MrChros/MIDI_Lighter/Doc/Calculations/Random_MIDI_Data_XR18_01.png

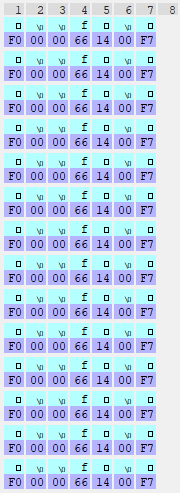
Doc/Calculations/Random_MIDI_Data_XR18_01.png
