MrChros/MIDI_Lighter/Doc/Calculations/Random_MIDI_Data_XR18_02.png

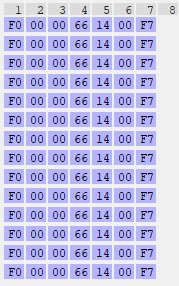
Doc/Calculations/Random_MIDI_Data_XR18_02.png
