MrChros/MIDI_Lighter/Doc/Calculations/Random_MIDI_Data_XR18_03.png

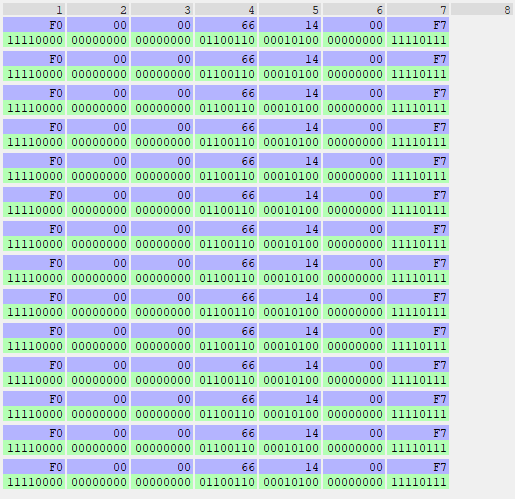
Doc/Calculations/Random_MIDI_Data_XR18_03.png
