MrChros/MIDI_Lighter/Doc/Circuit_Ideas/AD8217_Protection_Circuit.png

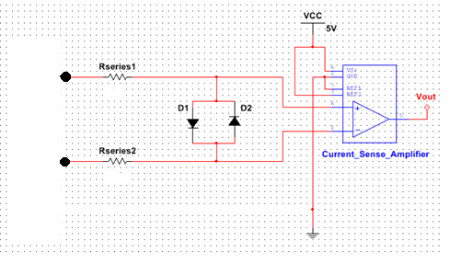
Doc/Circuit_Ideas/AD8217_Protection_Circuit.png
