MrChros/MIDI_Lighter/Doc/Circuit_Ideas/Ersatz74LS07.PNG

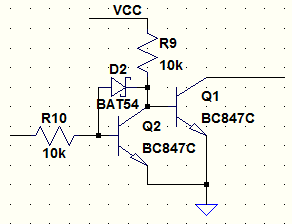
Doc/Circuit_Ideas/Ersatz74LS07.PNG
