MrChros/MIDI_Lighter/Doc/BOM_LCSC_MV.xlsx

Note: precise search for LCSC part number.
Quantity | Manufacture Part Number | Manufacturer(optional) | Description(optional) | LCSC Part Number(optional) | Package(optional)
100 | 0805W8F1000T5E | Uniroyal Elec | Chip Resistor - Surface Mount 0805 | C17408 | 0805
100 | 0805W8F1001T5E | Uniroyal Elec | Chip Resistor - Surface Mount 0805 | C17513 | 0805
100 | 0805W8F1002T5E | Uniroyal Elec | Chip Resistor - Surface Mount 0805 | C17414 | 0805
30 | - | Hubei KENTO Elec | Light Emitting Diodes (LED) 0805 | C2297 | 0805
20 | 17-21SUYC/TR8 | Hubei KENTO Elec | Light Emitting Diodes (LED) 0805 | C2296 | 0805
20 | 17-21/BHC-AP1Q2/3T | Everlight Elec | Light Emitting Diodes (LED) 0805 | C99870 | 0805
20 | - | Hubei KENTO Elec | Light Emitting Diodes (LED) 0805 | C34499 | 0805
15 | IRLML2246TRPBF | Infineon Technologies | MOSFET SOT-23(SOT-23-3) | C127272 | SOT-23(SOT-23-3)
7 | LM1117MPX-5.0/NOPB | Texas Instruments | Low Dropout Regulators(LDO) SOT-223 RoHS | C9663 | SOT-223
7 | MCP1703AT-5002E/CB | Microchip Tech | Low Dropout Regulators(LDO) SOT-23(SOT-23-3) | C144342 | SOT-23(SOT-23-3)
10 | HC-49SM16MHz20pF30ppm | Zhejiang Abel Elec | 49SMD 16MHz ±30ppm 49SMD | C111377 | 49SMD
10 | - | Shenzhen Cankemeng | Male Header Plugin | C124373 | Plugin
7 | 10118193-0001LF | Amphenol ICC | USB Connectors Female Horizontal USB 2.0 1 SMD RoHS | C132562 | SMD
7 | CR2512F0R05E042W | Ever Ohms Tech | Ultra Low Resistors (SMD) 2512 | C176035 | 2512
7 | AD8217BRMZ-R7 | Analog Devices | Operational Amplifiers MSOP-8 | C141937 | MSOP-8
