MrChros/MIDI_Lighter/Doc/Costs.xls

Sheet: Import
Spalte1 | Spalte2 | Spalte3

Sheet: Multi-Voltage (MV)
 |  |  |  |  |  |  |  |  |  |  |  |  |  |  |  |  |  |  | Yes
Components available at both stores: |  |  |  |  |  |  |  |  |  |  |  |  |  |  |  |  |  |  | No
# | Component | Amount | Reichelt Code | Reichelt per Piece | Min. Reichelt | Final Reichelt | Reichelt Total | LCSC Code | LCSC per Piece | Min. LCSC | Final LCSC | LCSC Avail. | LCSC Total | Avail. | Have to Reichelt | Have to LCSC | Have to Min. | Store
1 | Resistor 22 | 2 | RND 0805 1 22 | 0.02 € | 1 | 14 | 0.28 € | C65068 | 0.01 € | 100 | 100 | Yes | 0.69 € | Yes | 0.00 € | 0.00 € | 0.00 € | -
2 | Resistor 100 | 6 | RND 0805 1 100 | 0.02 € | 1 | 40 | 0.80 € | C17408 | 0.0033 € | 100 | 100 | Yes | 0.33 € | No | 0.80 € | 0.33 € | 0.33 € | LCSC
3 | Resistor 220 | 3 | RND 0805 1 220 | 0.02 € | 1 | 20 | 0.40 € | C17557 | 0.0045 € | 100 | 100 | Yes | 0.45 € | Yes | 0.00 € | 0.00 € | 0.00 € | -
4 | Resistor 500 | 4 | RND 0805 1 510 | 0.02 € | 1 | 25 | 0.50 € | C17734 | 0.0039 € | 100 | 100 | Yes | 0.39 € | Yes | 0.00 € | 0.00 € | 0.00 € | -
5 | Resistor 1k | 4 | SMD-0805 1,00K | 0.03 € | 1 | 25 | 0.75 € | C17513 | 0.01 € | 100 | 100 | Yes | 0.51 € | No | 0.75 € | 0.51 € | 0.51 € | LCSC
6 | Resistor 2k | 3 | SPR-0805 2,00K | 0.25 € | 1 | 20 | 5.00 € | C17604 | 0.0045 € | 100 | 100 | Yes | 0.45 € | Yes | 0.00 € | 0.00 € | 0.00 € | -
7 | Resistor 10k | 10 | SMD-0805 10,0K | 0.03 € | 1 | 50 | 1.50 € | C17414 | 0.01 € | 100 | 100 | Yes | 0.51 € | No | 1.50 € | 0.51 € | 0.51 € | LCSC
8 | Resistor 33k | 1 | SMD-0805 33,0K | 0.03 € | 1 | 7 | 0.21 € | C17633 | 0.0041 € | 100 | 100 | Yes | 0.41 € | Yes | 0.00 € | 0.00 € | 0.00 € | -
9 | Resistor 120k | 1 | SMD-0805 120K | 0.03 € | 1 | 7 | 0.21 € | C17436 | 0.0033 € | 100 | 100 | Yes | 0.33 € | Yes | 0.00 € | 0.00 € | 0.00 € | -
10 | Capacitor 22p | 2 | KEM C0G0805 22P | 0.01 € | 1 | 14 | 0.14 € | C38143 | 0.02 € | 50 | 50 | Yes | 0.84 € | Yes | 0.00 € | 0.00 € | 0.00 € | -
11 | Capacitor 100n | 3 | KEM Z5U0805 100N | 0.03 € | 1 | 20 | 0.60 € | C85866 | 0.06 € | 10 | 20 | Yes | 1.17 € | Yes | 0.00 € | 0.00 € | 0.00 € | -
12 | Capacitor 1u | 4 | KEM Y5V0805 1,0U | 0.01 € | 1 | 25 | 0.25 € | C28323 | 0.04 € | 10 | 30 | Yes | 1.25 € | Yes | 0.00 € | 0.00 € | 0.00 € | -
13 | Capacitor 10u Tantal | 2 | TPS 3225 10/20 | 0.32 € | 1 | 14 | 4.48 € | C189401 | 0.80 € | 1 | 14 | Yes | 11.24 € | No | 4.48 € | 11.24 € | 4.48 € | Reichelt
14 | LED Green | 4 | LG R971 | 0.05 € | 1 | 25 | 1.25 € | C2297 | 0.02 € | 10 | 30 | Yes | 0.46 € | No | 1.25 € | 0.46 € | 0.46 € | LCSC
15 | LED Orange/Gelb | 1 | LY R976 | 0.06 € | 1 | 7 | 0.42 € | C2296 | 0.01 € | 20 | 20 | Yes | 0.20 € | No | 0.42 € | 0.20 € | 0.20 € | LCSC
16 | LED Blue | 1 | RND 135-00047 | 0.07 € | 1 | 7 | 0.49 € | C99870 | 0.03 € | 10 | 10 | Yes | 0.34 € | No | 0.49 € | 0.34 € | 0.34 € | LCSC
17 | LED White | 1 | LED LL 0805 WS | 0.16 € | 1 | 7 | 1.12 € | C34499 | 0.01 € | 20 | 20 | Yes | 0.27 € | No | 1.12 € | 0.27 € | 0.27 € | LCSC
18 | n-MOSFET IRLML6346 | 6 | IRLML 6346 | 0.18 € | 1 | 37 | 6.66 € | C67276 | 0.10 € | 5 | 40 | No | 3.88 € | No | 6.66 € | 3.88 € | 3.88 € | Reichelt
19 | p-MOSFET IRLML2246 | 2 | IRLML 2246 | 0.14 € | 1 | 13 | 1.82 € | C127272 | 0.11 € | 5 | 15 | Yes | 1.61 € | No | 1.82 € | 1.61 € | 1.61 € | LCSC
20 | p-MOSFET IRF7416 | 1 | IRF 7416 | 0.47 € | 1 | 7 | 3.29 € | C3000 | 0.37 € | 1 | 7 | Yes | 2.58 € | Yes | 0.00 € | 0.00 € | 0.00 € | -
21 | LM 1117 MPX-5.0 | 1 | LM 1117 MPX-5.0 | 0.86 € | 1 | 7 | 6.02 € | C9663 | 0.74 € | 1 | 7 | Yes | 5.15 € | No | 6.02 € | 5.15 € | 5.15 € | LCSC
22 | MCP1703CB | 1 | MCP 1703T-3302E | 0.76 € | 1 | 7 | 5.32 € | C144342 | 0.44 € | 1 | 7 | Yes | 3.09 € | No | 5.32 € | 3.09 € | 3.09 € | LCSC
23 | ATmega32u4 | 1 | ATXMEGA 32A4U-AU | 2.80 € | 1 | 7 | 19.60 € | C44854 | 3.34 € | 1 | 7 | Yes | 23.35 € | No | 19.60 € | 23.35 € | 19.60 € | Reichelt
24 | ATtiny13 | 1 | ATTINY 13A-SSU | 0.88 € | 1 | 7 | 6.16 € | C9805 | 0.64 € | 1 | 7 | No | 4.49 € | No | 6.16 € | 4.49 € | 4.49 € | Reichelt
25 | 74LS14D | 1 | SMD LS 14 | 0.27 € | 1 | 7 | 1.89 € | C7653 | 0.96 € | 1 | 7 | Yes | 6.73 € | No | 1.89 € | 6.73 € | 1.89 € | Reichelt
26 | Optokoppler H11L1M | 1 | H11L1M | 0.48 € | 1 | 7 | 3.36 € | C16587 | 0.39 € | 1 | 7 | No | 2.75 € | No | 3.36 € | 2.75 € | 2.75 € | Reichelt
27 | Quarz CSM-7X-DU | 1 | 16,0000-HC49-SMD | 0.29 € | 1 | 7 | 2.03 € | C111377 | 0.07 € | 5 | 10 | Yes | 0.70 € | No | 2.03 € | 0.70 € | 0.70 € | LCSC
28 | Pin Header 1x11 | 1 | MPE 087-1-012 | 0.28 € | 1 | 7 | 1.96 € | C124373 | 0.07 € | 5 | 10 | Yes | 0.65 € | No | 1.96 € | 0.65 € | 0.65 € | LCSC
29 | npn-Transistor BC847C | 2 | BC 847C NXP | 0.02 € | 1 | 13 | 0.26 € | C150094 | 0.02 € | 20 | 20 | Yes | 0.33 € | No | 0.26 € | 0.33 € | 0.26 € | Reichelt
30 | Schottky-Diode BAT54 | 1 | BAT 54 SMD | 0.03 € | 1 | 7 | 0.21 € | C188282 | 0.04 € | 10 | 10 | Yes | 0.36 € | No | 0.21 € | 0.36 € | 0.21 € | Reichelt
 |  |  |  |  |  |  |  |  |  |  |  |  |  |  | Reichelt | LCSC | Minimum
 |  |  |  |  |  | Total: | 76.98 € |  |  |  | Total: |  | 75.50 € |  | 66.10 € | 66.94 € | 51.38 €
 |  |  |  |  |  |  |  |  |  |  |  |  |  |  |  | Reichelt: | 37.56 €
Left over components: |  |  |  |  |  |  |  |  |  |  |  |  |  |  |  | LCSC: | 13.82 €
# | Component | Amout | Reichelt | LCSC
1 | 2.5MM_SMD_PUSHBUTTON | 2 |  |  |  |  |  |  |  |  |  |  |  |  |  | Summe: | 51.38 €
2 | DIN-Buchse, 5-polig | 2 | MABPM 5S
3 | H11L1M Socket | 1 | GS 6P
4 | Micro USB Plug | 1 |  | C132562
5 | Diode 1N4001 | 1 | 1N 4001 SMD
6 | Diode 1N914 | 1 | 1N 914
7 | n-MOSFET AO3400A | 0 |  | C20917
8 | Shunt Resistor 0,05/1W | 0 |  | C176035
9 | Stromshunt Monitor AD8217 | 0 |  | C141937
10 | Connector RGB-Strip | 1
11 | Adapter Power Supply | 1 | DC BU21 90
12 | Distanzhülsen, M3, 5mm |  | DA 5MM
13 | Distanzhülsen, M3, 5mm |  | DI 5MM
14 | Distanzhülsen, M3, 10mm |  | DA 10MM
15 | Distanzhülsen, M3, 10mm |  | DI 10MM
16 | Sechskantmuttern, M3 |  | SK M3
17 | Schrauben, M3, 6 mm |  | SZK M3X6-200
18 | Schrauben, M3, 10 mm |  | SZK M3X10-200
19 | Schrauben, M3, 25 mm |  | SZK M3X25-200
 | Components per board: | 82

Sheet: +12V Only
 |  |  |  |  |  |  |  |  |  |  |  |  |  |  |  |  |  |  | Yes
Components available at both stores: |  |  |  |  |  |  |  |  |  |  |  |  |  |  |  |  |  |  | No
# | Component | Amount | Reichelt Code | Reichelt per Piece | Min. Reichelt | Final Reichelt | Reichelt Total | LCSC Code | LCSC per Piece | Min. LCSC | Final LCSC | LCSC Avail. | LCSC Total | Avail. | Have to Reichelt | Have to LCSC | Have to Min. | Store
1 | Resistor 22 | 2 | RND 0805 1 22 | 0.02 € | 1 | 14 | 0.28 € | C65068 | 0.01 € | 100 | 100 | Yes | 0.69 € | Yes | 0.00 € | 0.00 € | 0.00 € | -
2 | Resistor 100 | 4 | RND 0805 1 100 | 0.02 € | 1 | 25 | 0.50 € | C17408 | 0.0033 € | 100 | 100 | Yes | 0.33 € | No | 0.50 € | 0.33 € | 0.33 € | LCSC
3 | Resistor 220 | 3 | RND 0805 1 220 | 0.02 € | 1 | 20 | 0.40 € | C17557 | 0.0045 € | 100 | 100 | Yes | 0.45 € | Yes | 0.00 € | 0.00 € | 0.00 € | -
4 | Resistor 500 | 4 | RND 0805 1 510 | 0.02 € | 1 | 25 | 0.50 € | C17734 | 0.0039 € | 100 | 100 | Yes | 0.39 € | Yes | 0.00 € | 0.00 € | 0.00 € | -
5 | Resistor 1k | 2 | SMD-0805 1,00K | 0.03 € | 1 | 15 | 0.45 € | C17513 | 0.01 € | 100 | 100 | Yes | 0.51 € | Yes | 0.00 € | 0.00 € | 0.00 € | -
6 | Resistor 2k | 1 | SPR-0805 2,00K | 0.25 € | 1 | 7 | 1.75 € | C17604 | 0.0045 € | 100 | 100 | Yes | 0.45 € | Yes | 0.00 € | 0.00 € | 0.00 € | -
7 | Resistor 10k | 8 | SMD-0805 10,0K | 0.03 € | 1 | 50 | 1.50 € | C17414 | 0.01 € | 100 | 100 | Yes | 0.51 € | No | 1.50 € | 0.51 € | 0.51 € | LCSC
8 | Capacitor 22p | 2 | KEM C0G0805 22P | 0.01 € | 1 | 15 | 0.15 € | C38143 | 0.02 € | 50 | 50 | Yes | 0.84 € | Yes | 0.00 € | 0.00 € | 0.00 € | -
9 | Capacitor 100n | 3 | KEM Z5U0805 100N | 0.03 € | 1 | 20 | 0.60 € | C85866 | 0.06 € | 10 | 20 | Yes | 1.17 € | Yes | 0.00 € | 0.00 € | 0.00 € | -
10 | Capacitor 1u | 2 | KEM Y5V0805 1,0U | 0.01 € | 1 | 15 | 0.15 € | C28323 | 0.04 € | 10 | 10 | Yes | 0.42 € | Yes | 0.00 € | 0.00 € | 0.00 € | -
11 | Capacitor 10u Tantal | 2 | TPS 3225 10/20 | 0.32 € | 1 | 14 | 4.48 € | C189401 | 0.80 € | 1 | 14 | Yes | 11.24 € | No | 4.48 € | 11.24 € | 4.48 € | Reichelt
12 | LED Green | 4 | LG R971 | 0.05 € | 1 | 25 | 1.25 € | C2297 | 0.02 € | 10 | 30 | Yes | 0.46 € | No | 1.25 € | 0.46 € | 0.46 € | LCSC
13 | LED Orange/Gelb | 1 | LY R976 | 0.06 € | 1 | 7 | 0.42 € | C2296 | 0.01 € | 20 | 20 | Yes | 0.20 € | No | 0.42 € | 0.20 € | 0.20 € | LCSC
14 | n-MOSFET IRLML6346 | 4 | IRLML 6346 | 0.18 € | 1 | 25 | 4.50 € | C67276 | 0.10 € | 5 | 25 | No | 2.43 € | No | 4.50 € | 2.43 € | 2.43 € | Reichelt
15 | p-MOSFET IRF7416 | 1 | IRF 7416 | 0.47 € | 1 | 7 | 3.29 € | C3000 | 0.37 € | 1 | 7 | Yes | 2.58 € | Yes | 0.00 € | 0.00 € | 0.00 € | -
16 | LM 1117 MPX-5.0 | 1 | LM 1117 MPX-5.0 | 0.86 € | 1 | 7 | 6.02 € | C9663 | 0.74 € | 1 | 7 | Yes | 5.15 € | No | 6.02 € | 5.15 € | 5.15 € | LCSC
17 | ATmega32u4 | 1 | ATXMEGA 32A4U-AU | 2.80 € | 1 | 7 | 19.60 € | C44854 | 3.34 € | 1 | 7 | Yes | 23.35 € | No | 19.60 € | 23.35 € | 19.60 € | Reichelt
18 | 74LS14D | 1 | SMD LS 14 | 0.27 € | 1 | 7 | 1.89 € | C7653 | 0.96 € | 1 | 7 | Yes | 6.73 € | No | 1.89 € | 6.73 € | 1.89 € | Reichelt
19 | Optokoppler H11L1M | 1 | H11L1M | 0.48 € | 1 | 7 | 3.36 € | C16587 | 0.39 € | 1 | 7 | No | 2.75 € | No | 3.36 € | 2.75 € | 2.75 € | Reichelt
20 | Quarz CSM-7X-DU | 1 | 16,0000-HC49-SMD | 0.29 € | 1 | 7 | 2.03 € | C111377 | 0.07 € | 5 | 10 | Yes | 0.70 € | No | 2.03 € | 0.70 € | 0.70 € | LCSC
21 | Pin Header 1x11 | 1 | MPE 087-1-012 | 0.28 € | 1 | 7 | 1.96 € | C124373 | 0.07 € | 5 | 10 | Yes | 0.65 € | No | 1.96 € | 0.65 € | 0.65 € | LCSC
22 | npn-Transistor BC847C | 2 | BC 847C NXP | 0.02 € | 1 | 13 | 0.26 € | C150094 | 0.02 € | 20 | 20 | Yes | 0.33 € | No | 0.26 € | 0.33 € | 0.26 € | Reichelt
23 | Schottky-Diode BAT54 | 1 | BAT 54 SMD | 0.03 € | 1 | 7 | 0.21 € | C188282 | 0.04 € | 10 | 10 | Yes | 0.36 € | No | 0.21 € | 0.36 € | 0.21 € | Reichelt
 |  |  |  |  |  |  |  |  |  |  |  |  |  |  | Reichelt | LCSC | Minimum
 |  |  |  |  |  | Total: | 55.55 € |  |  |  | Total: |  | 62.68 € |  | 47.98 € | 55.19 € | 39.62 €
 |  |  |  |  |  |  |  |  |  |  |  |  |  |  |  | Reichelt: | 31.62 €
Left over components: |  |  |  |  |  |  |  |  |  |  |  |  |  |  |  | LCSC: | 8.00 €
# | Component | Amout | Reichelt | LCSC
1 | 2.5MM_SMD_PUSHBUTTON | 2 |  |  |  |  |  |  |  |  |  |  |  |  |  | Summe: | 39.62 €
2 | DIN-Buchse, 5-polig | 2 | MABPM 5S
3 | H11L1M Socket | 1 | GS 6P
4 | Micro USB Plug | 1 |  | C132562
5 | Diode 1N4001 | 1 | 1N 4001 SMD
6 | Diode 1N914 | 1 | 1N 914
7 | n-MOSFET AO3400A | 0 |  | C20917
8 | Shunt Resistor 0,05/1W | 0 |  | C176035
9 | Stromshunt Monitor AD8217 | 0 |  | C141937
10 | Connector RGB-Strip | 1
11 | Adapter Power Supply | 1 | DC BU21 90
12 | Distanzhülsen, M3, 5mm |  | DA 5MM
13 | Distanzhülsen, M3, 5mm |  | DI 5MM
14 | Distanzhülsen, M3, 10mm |  | DA 10MM
15 | Distanzhülsen, M3, 10mm |  | DI 10MM
16 | Sechskantmuttern, M3 |  | SK M3
17 | Schrauben, M3, 6 mm |  | SZK M3X6-200
18 | Schrauben, M3, 10 mm |  | SZK M3X10-200
19 | Schrauben, M3, 25 mm |  | SZK M3X25-200
 | Components per board: | 62
