MrChros/MIDI_Lighter/Housing/MIDI_Lighter_12V_Only_Top_Debug.stl

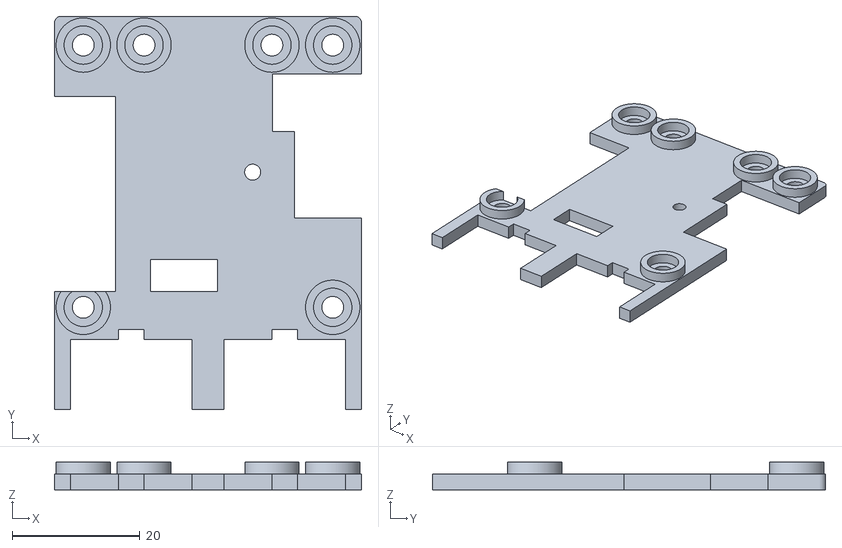
[picture p7: CAD file, 2022-03-05]
Housing/MIDI_Lighter_12V_Only_Top_Debug.stl
48.0 x 61.5 x 4.38
