MrChros/MIDI_Lighter/Housing/MIDI_Lighter_12V_Only_Top_Cable_Relief.stl

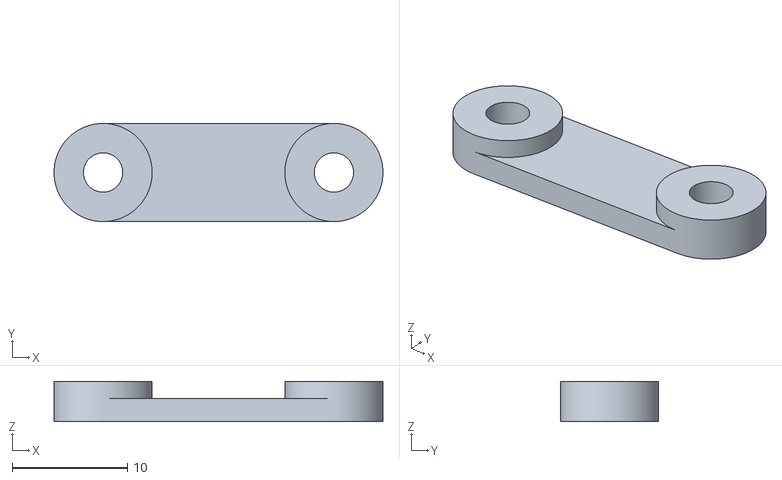
[picture p8: CAD file, 2022-03-05]
Housing/MIDI_Lighter_12V_Only_Top_Cable_Relief.stl
28.5 x 8.50 x 3.50
