MrChros/MIDI_Lighter/Housing/MIDI_Lighter_12V_Only_Bottom.stl

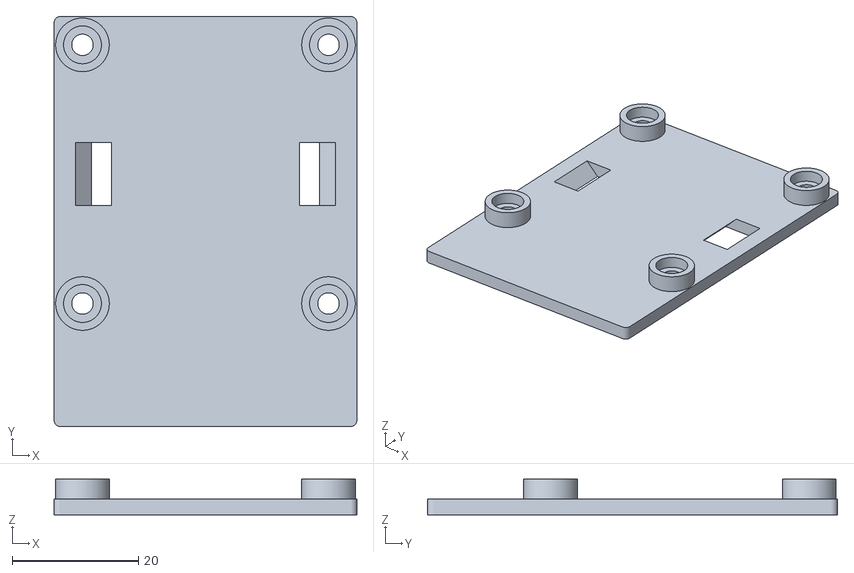
[picture p9: CAD file, 2022-03-05]
Housing/MIDI_Lighter_12V_Only_Bottom.stl
48.0 x 65.0 x 5.70
