MrChros/MIDI_Lighter/(list of files, cad)

Other CAD files:
Housing/MIDI_Lighter_12V_Only_Top_Debug.scad
