MrChros/MIDI_Lighter/Doc/Calculations/Current_Measurement.xlsx

 |  |  | Prescaler 4 |  | Prescaler 8 |  | Prescaler 16 |  | Prescaler 32 |  | Prescaler 64 |  | Reference Voltage: | 5000 | mV | 401
Timer4 Prescaler | Timer1 Top | #Measurement | ADC_Value | Current [mA] | ADC_Value | Current [mA] | ADC_Value | Current [mA] | ADC_Value | Current [mA] | ADC_Value | Current [mA] | ADC Resolution: | 1024
PRESCALER_4 | 4000 | 0 | 0.922 | 4.502 | 13.000 | 63.477 | 13.262 | 64.756 | 13.333 | 65.100 | 13.424 | 65.545
PRESCALER_4 | 4000 | 1 | 12.671 | 61.872 | 13.055 | 63.745 | 13.251 | 64.703 | 13.592 | 66.368 | 13.738 | 67.080
PRESCALER_4 | 4000 | 2 | 12.654 | 61.785 | 13.073 | 63.833 | 13.124 | 64.082 | 13.324 | 65.060 | 13.614 | 66.476
PRESCALER_4 | 4000 | 3 | 12.746 | 62.238 | 12.996 | 63.455 | 13.483 | 65.837 | 13.498 | 65.906 | 13.590 | 66.357
PRESCALER_4 | 4000 | 4 | 12.785 | 62.426 | 13.059 | 63.766 | 13.226 | 64.581 | 13.389 | 65.377 | 13.443 | 65.642
PRESCALER_4 | 4000 | 5 | 12.751 | 62.261 | 12.908 | 63.027 | 13.332 | 65.097 | 13.671 | 66.754 | 13.421 | 65.534
PRESCALER_4 | 4000 | 6 | 12.753 | 62.273 | 13.114 | 64.033 | 13.212 | 64.512 | 13.507 | 65.952 | 13.829 | 67.527
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
