MrChros/MIDI_Lighter/Doc/Export/MIDI_Lighter_PCB_Concept_12V.pdf

H

G

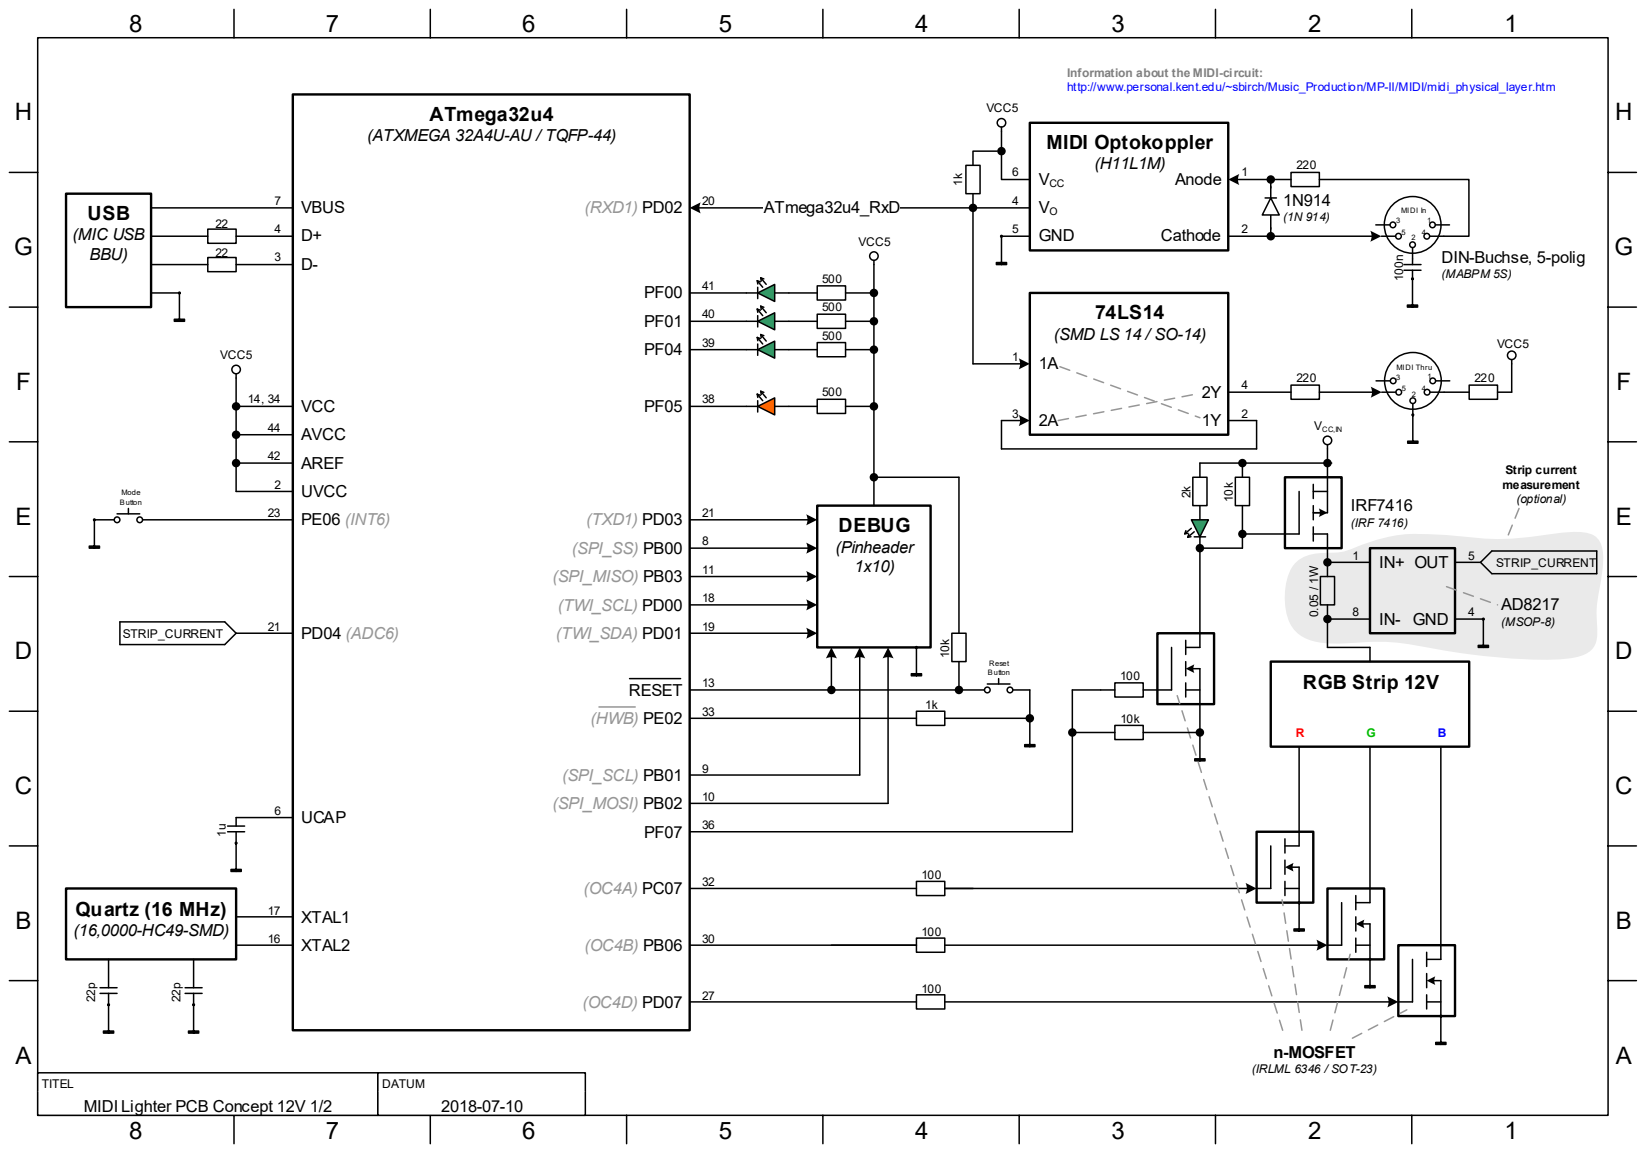
[picture p13: page 1]
DATUM; ATmega32u4; (ATXMEGA 32A4U-AU / TQFP-44); MIDI Optokoppler; ATmega32u4_RxD; DIN-Buchse, 5-polig; (MABPM 5S); Anode; GND; Cathode; VCC; VCC5; VBUS; (RXD1) PD02 ⁷; 22 USB; (MIC USB BBU); XTAL1; XTAL2; Quartz (16 MHz); (16,0000-HC49-SMD) 22p; PE06 (INT6); n-MOSFET; (IRLML 6346 / SOT-23); VCC,IN; RGB Strip 12V; 21 (TXD1) PD03; (SPI_SS) PB00; (SPI_SCL) PB01; 10 (SPI_MOSI) PB02; 11 (SPI_MISO) PB03; DEBUG; (Pinheader 1x10); 13 RESET; UCAP; AVCC; AREF; UVCC; (TWI_SCL) PD00; (TWI_SDA) PD01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

Information about the MIDI-circuit:
http://www.personal.kent.edu/~sbirch/Music_Production/MP-II/MIDI/midi_physical_layer.htm

(SMD LS 14 / SO-14)

TITEL
MIDI Lighter PCB Concept 12V 1/2

H

G

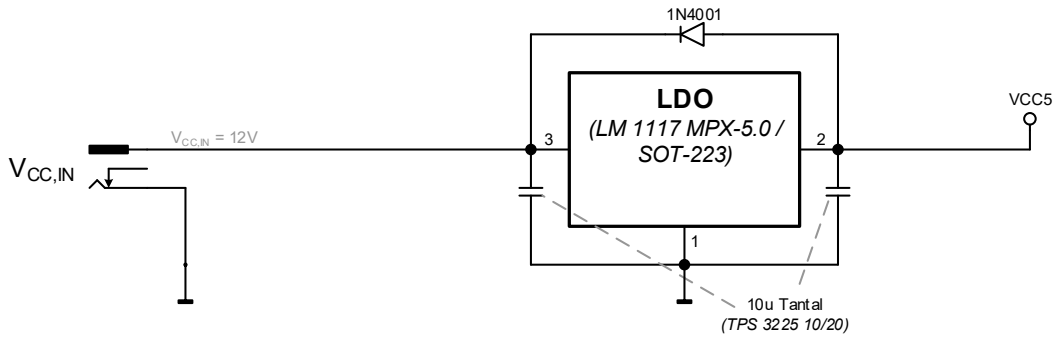
[picture p14: page 2]
DATUM; LDO; (LM 1117 MPX-5.0 / SOT-223); 10u Tantal (TPS 3225 10/20); VCC5; VCC,IN = 12V; VCC,IN

TITEL
MIDI Lighter PCB Concept 12V 2/2
