MrChros/MIDI_Lighter/Doc/Export/MIDI_Lighter_PCB_Concept_MV.pdf

H

G

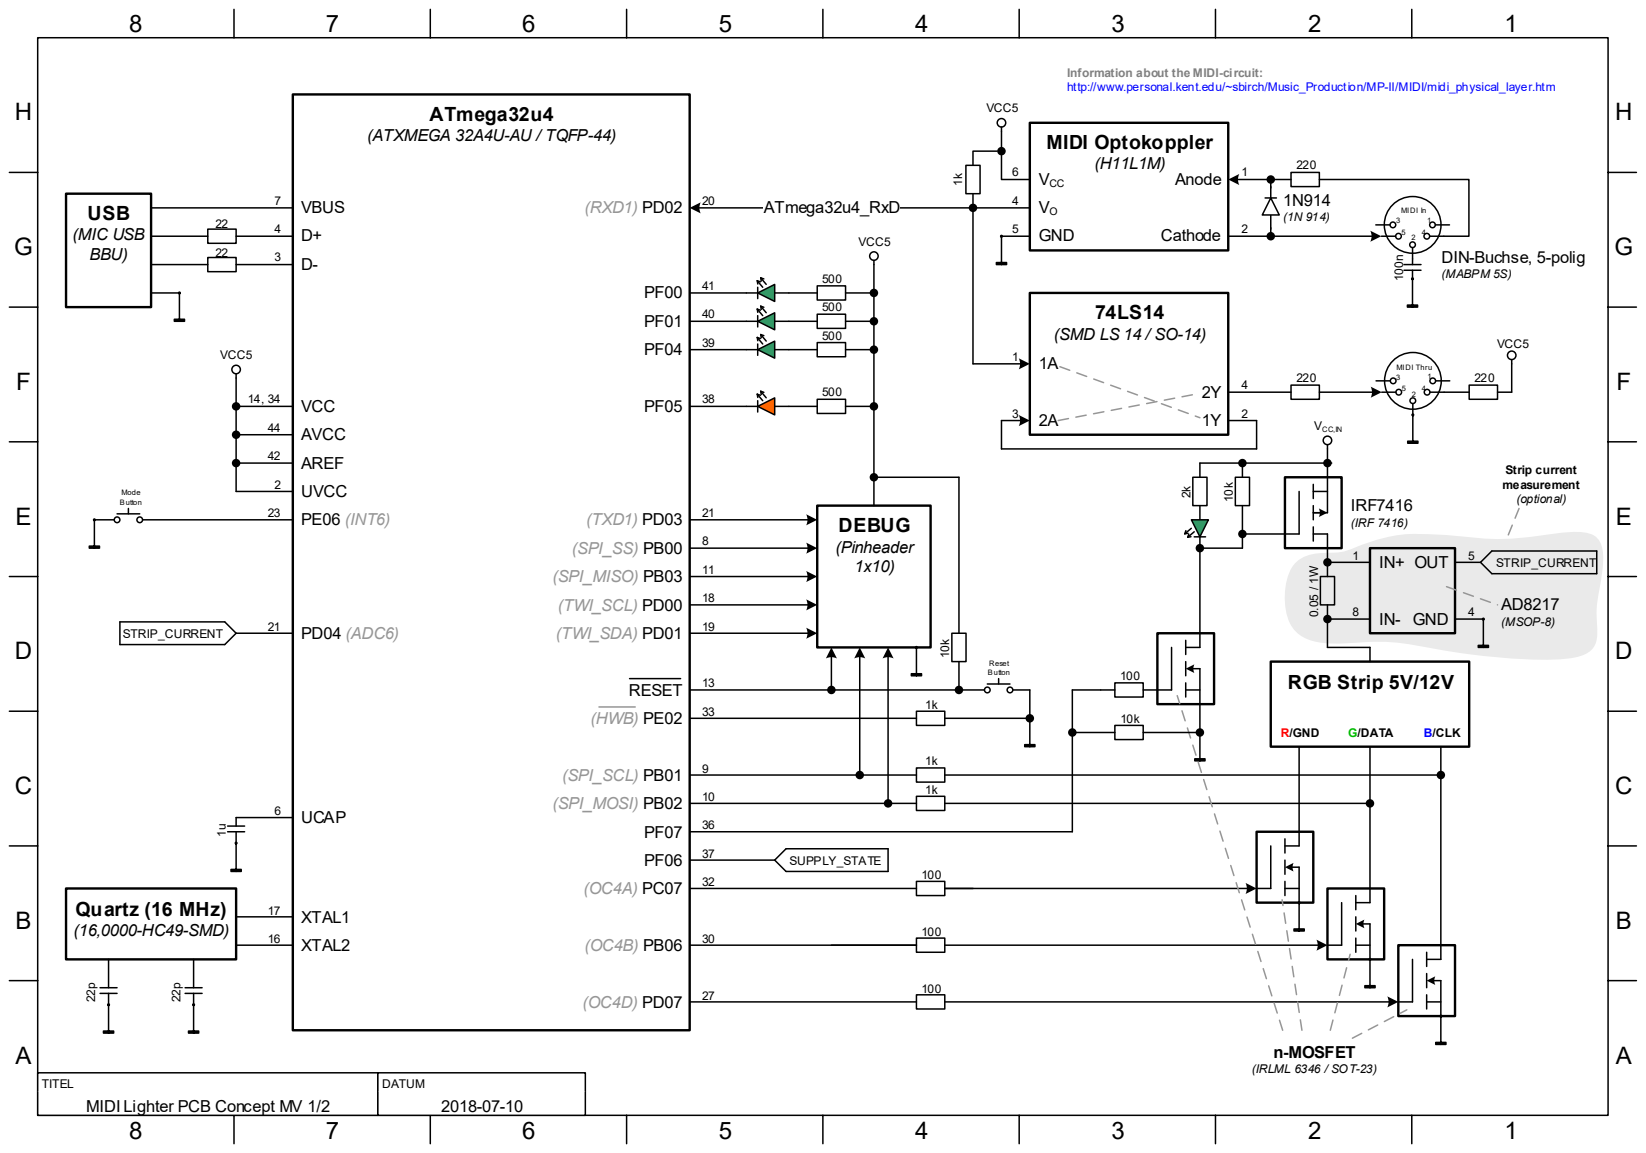
[picture p15: page 1]
ATmega32u4; (ATXMEGA 32A4U-AU / TQFP-44); MIDI Optokoppler; ATmega32u4_RxD; DIN-Buchse, 5-polig; (MABPM 5S); Anode; GND; Cathode; VCC; VCC5; VBUS; (RXD1) PD02 ⁷; 22 USB; (MIC USB BBU); XTAL1; XTAL2; Quartz (16 MHz); (16,0000-HC49-SMD) 22p; PE06 (INT6); n-MOSFET; (IRLML 6346 / SOT-23); VCC,IN; RGB Strip 5V/12V; R/GND; G/DATA; B/CLK; 21 (TXD1) PD03; (SPI_SS) PB00; (SPI_SCL) PB01; 10 (SPI_MOSI) PB02; 11 (SPI_MISO) PB03; DEBUG; (Pinheader 1x10); 13 RESET; UCAP; AVCC; AREF; UVCC; (TWI_SCL) PD00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

Information about the MIDI-circuit:
http://www.personal.kent.edu/~sbirch/Music_Production/MP-II/MIDI/midi_physical_layer.htm

(SMD LS 14 / SO-14)

TITEL
MIDI Lighter PCB Concept MV 1/2

H

G

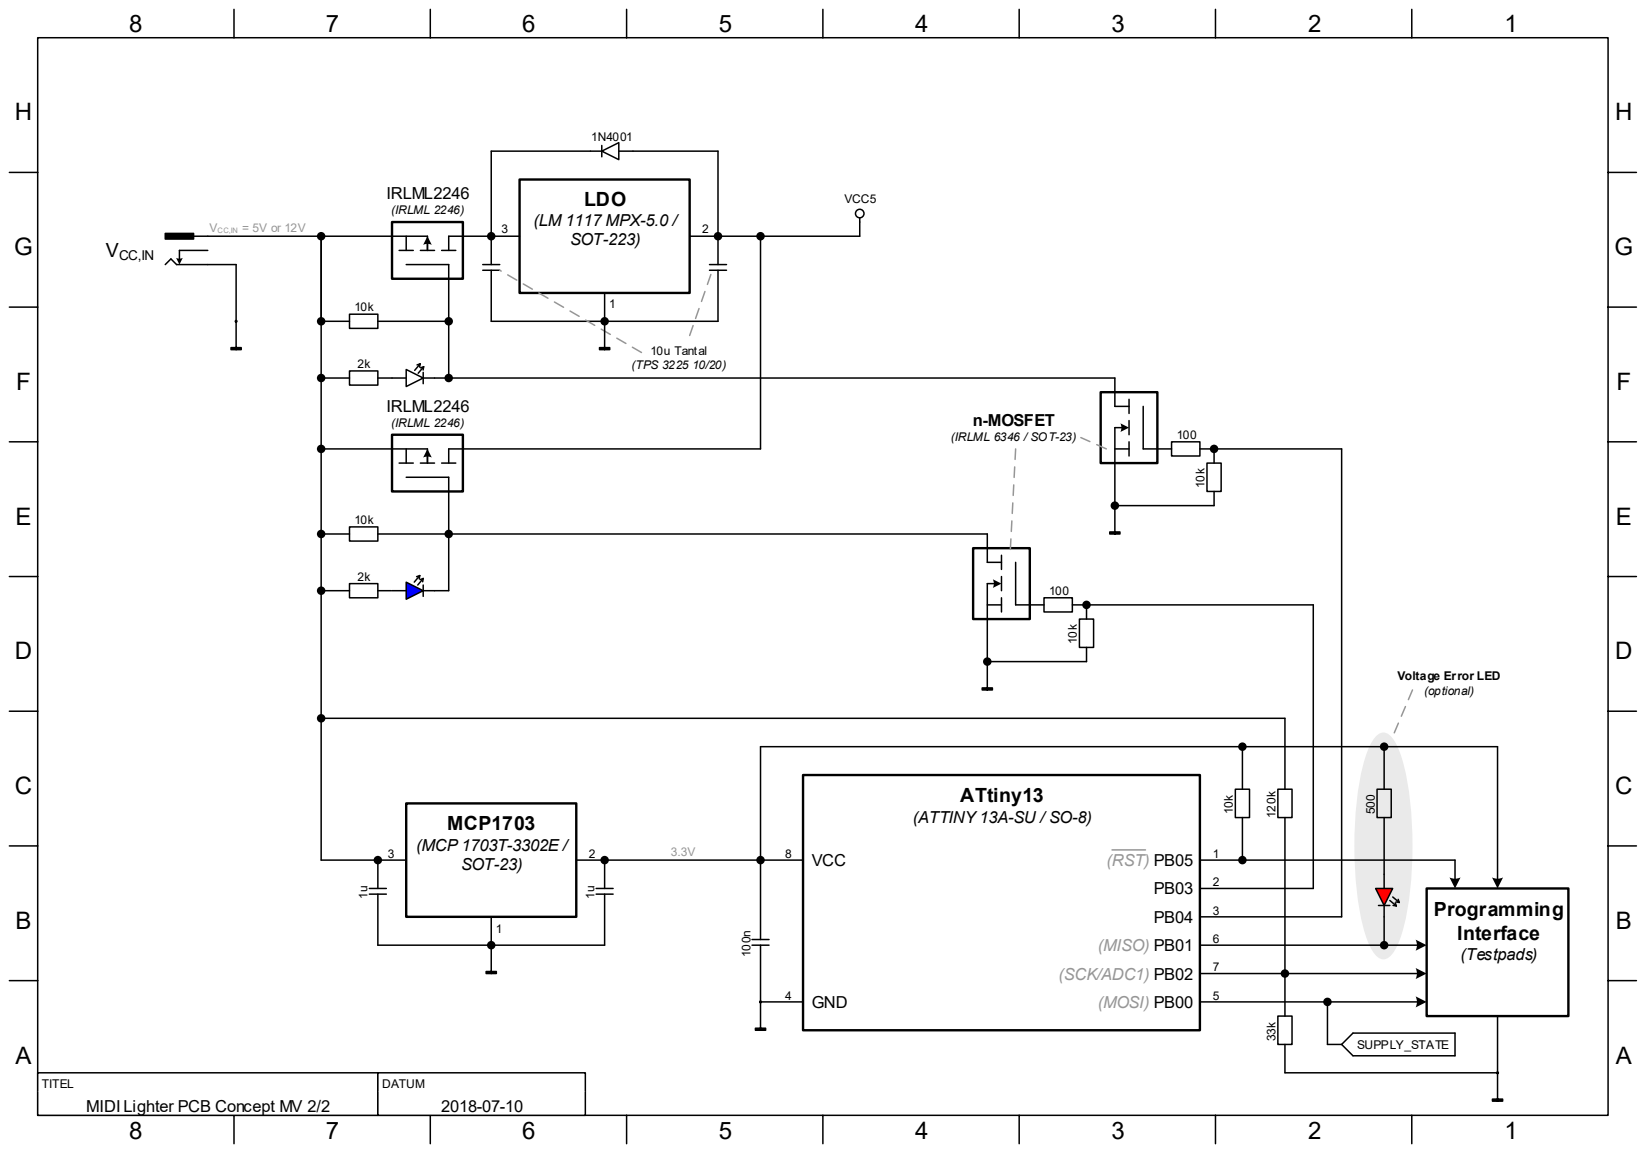
[picture p16: page 2]
LDO; (LM 1117 MPX-5.0 / SOT-223); 10u Tantal (TPS 3225 10/20); VCC5; ATtiny13; MCP; (ATTINY 13A-SU / SO-8) 1703; (MCP 1703T-3302E / SOT-23); VCC; GND ⁴; SUPPLY_STATE; (RST) PB05; (MOSI) PB00; (MISO) PB01; (SCK/ADC1) PB02; Programming Interface; (Testpads); IRLML2246; (IRLML 2246); VCC,IN; n-MOSFET; (IRLML 6346 / SOT-23); DATUM

VCC,IN = 5V or 12V

Voltage Error LED
(optional)

TITEL
MIDI Lighter PCB Concept MV 2/2
