MrChros/MIDI_Lighter/Doc/Export/MIDI_Lighter_PCB_Schematic_12V_v1.0.pdf

# SpiceOrder 2 SpiceOrder 1 GND

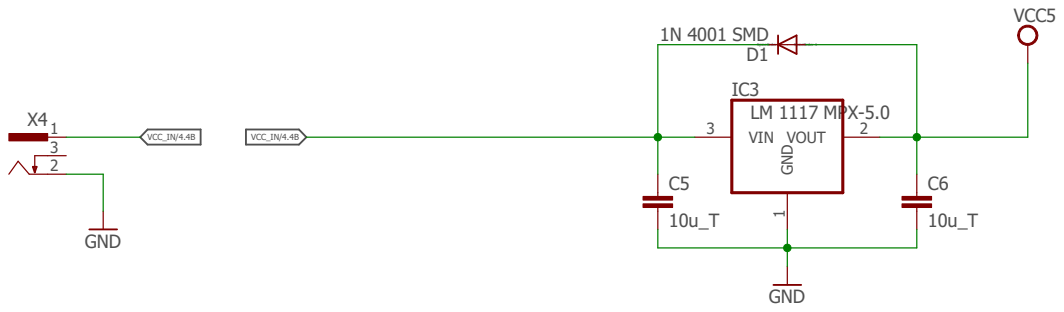
[picture p17: page 1]
VCC5; LM 1117 MPX-5.0; GND; 1N 4001 SMD; VIN 3; VOUT; 2 GND; VCC_IN/4.4B; TITLE:; MIDI_Lighter_12V_Only

Document Number: | REV:

Date: 10/07/2018 18:16 | Sheet: 1/4

# VCC5 10k

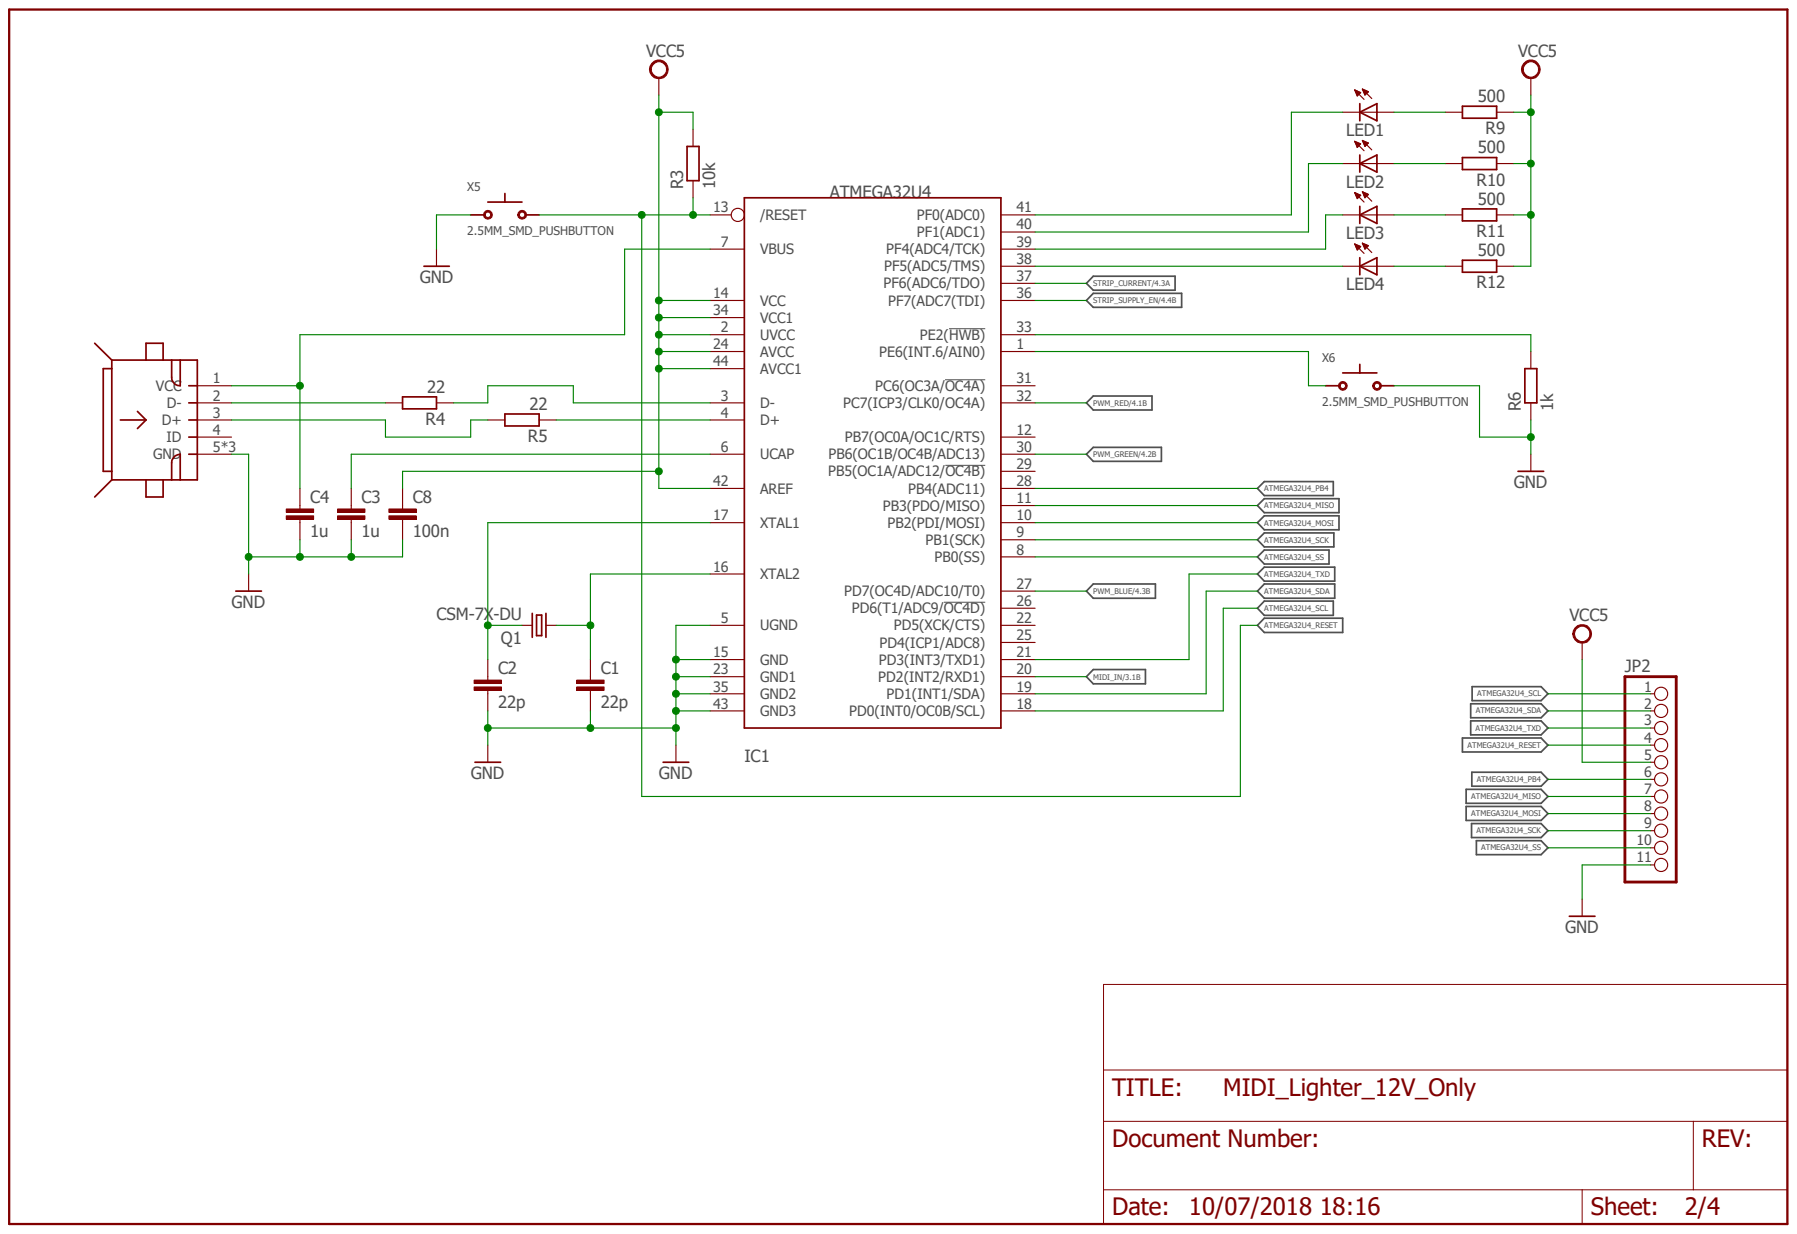
[picture p18: page 2]

UCAP 6

AREF 42

XTAL2 16

UGND 5

Document Number: | REV:

Date: 10/07/2018 18:16 | Sheet: 2/4

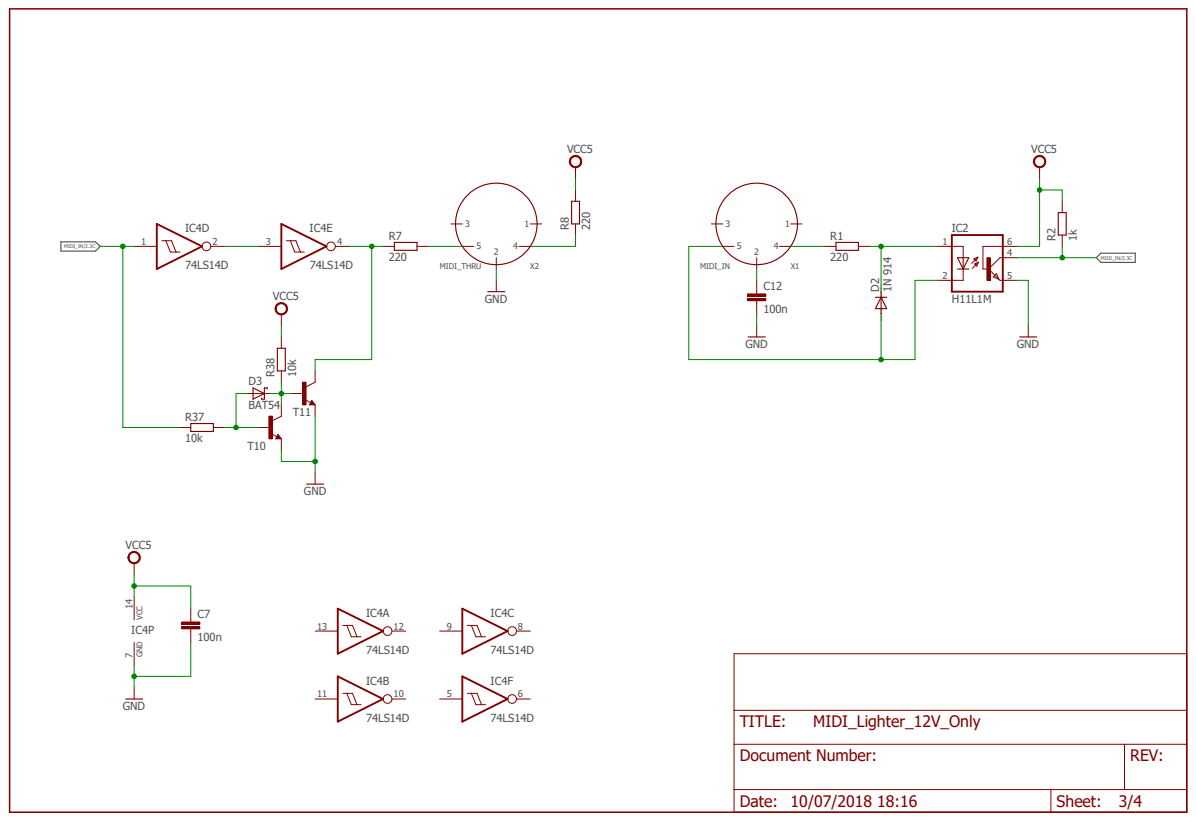
[picture p19: page 3]

Document Number: | REV:

Date: 10/07/2018 18:16 | Sheet: 3/4

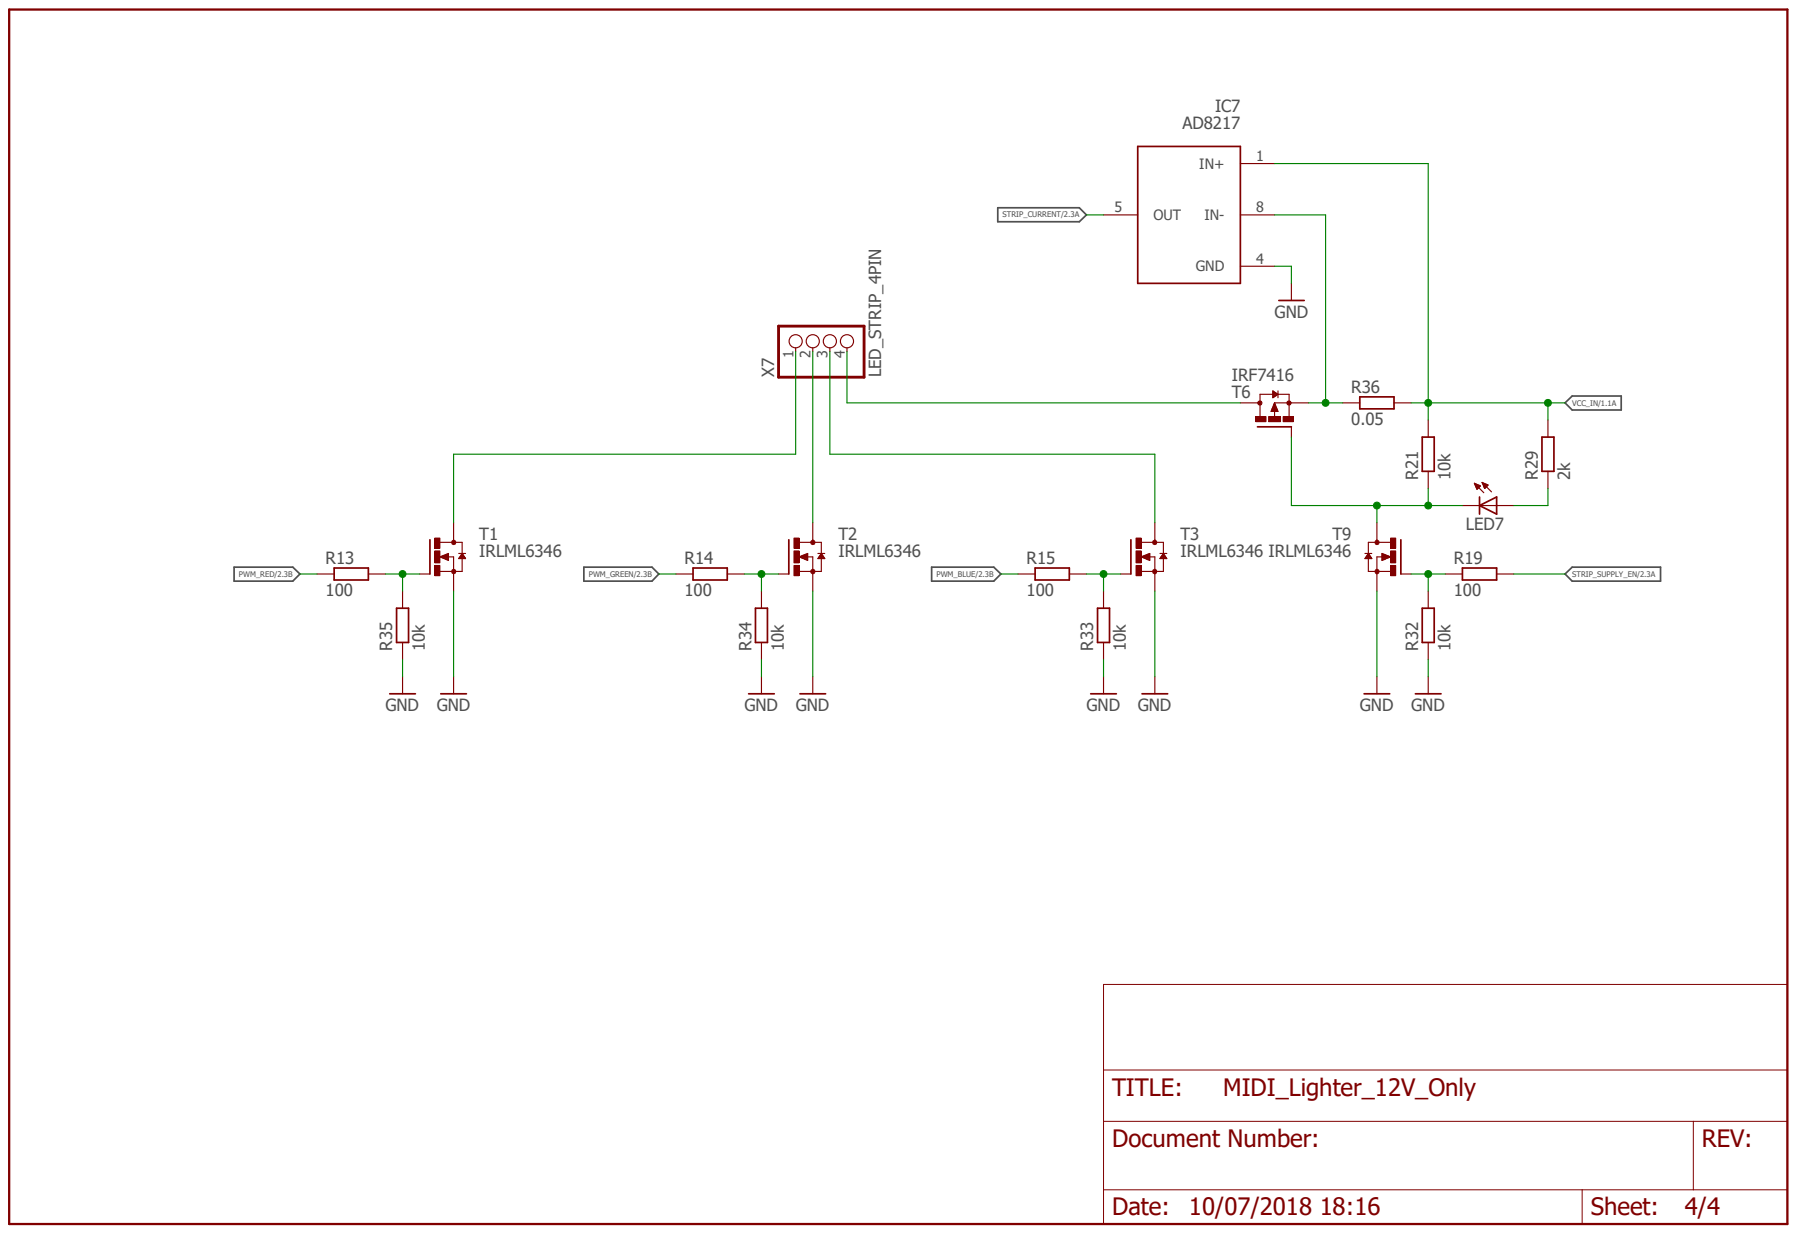
[picture p20: page 4]
IRLML6346; GND; GND LED_STRIP_4PIN; IRF7416; GND ¹⁰k; R²¹; R²⁹; LED7 R³⁵; R³⁴; R³³; R³²; OUT 5; PWM_RED/2.3B; PWM_GREEN/2.3B; PWM_BLUE/2.3B; VCC_IN/1.1A; STRIP_SUPPLY_EN/2.3A; STRIP_CURRENT/2.3A; TITLE:; MIDI_Lighter_12V_Only

Document Number: | REV:

Date: 10/07/2018 18:16 | Sheet: 4/4
