MrChros/MIDI_Lighter/Doc/Export/MIDI_Lighter_PCB_Schematic_MV.pdf

# SpiceOrder 2 SpiceOrder 1 GND

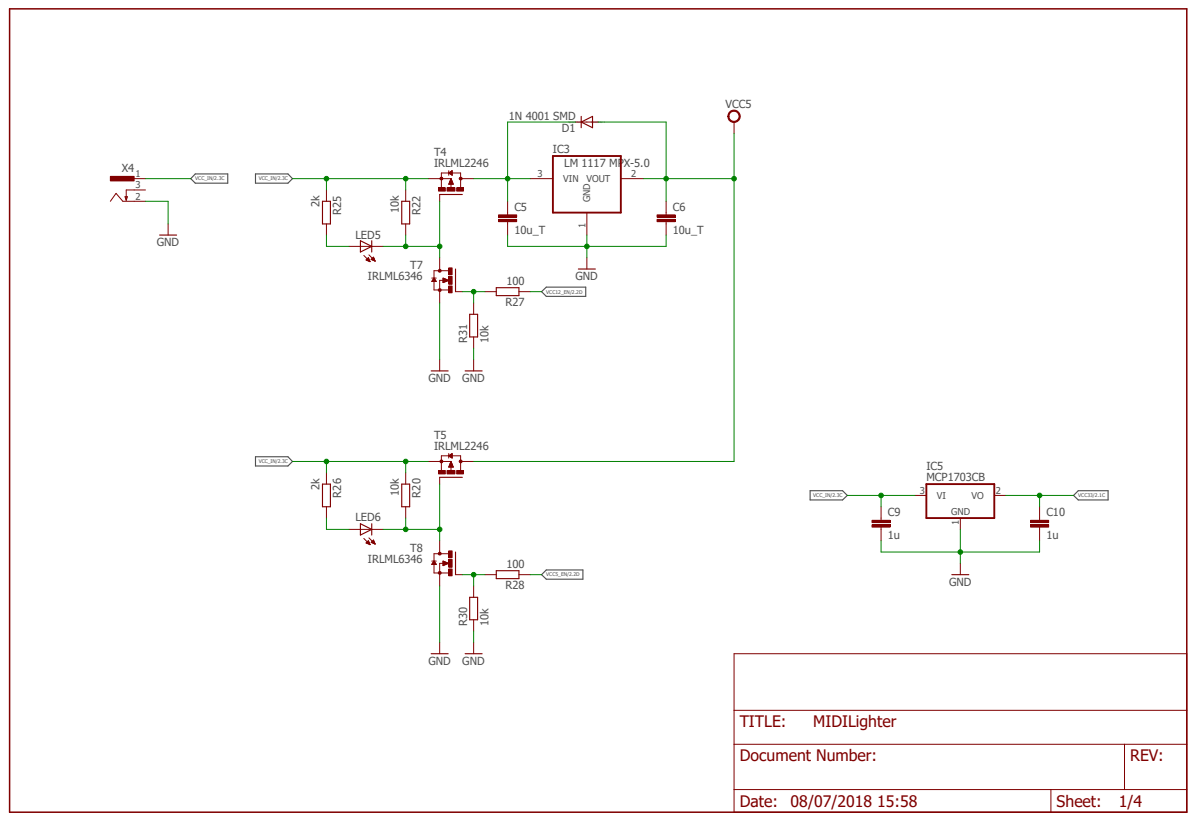
[picture p21: page 1]

# VCC5 10k

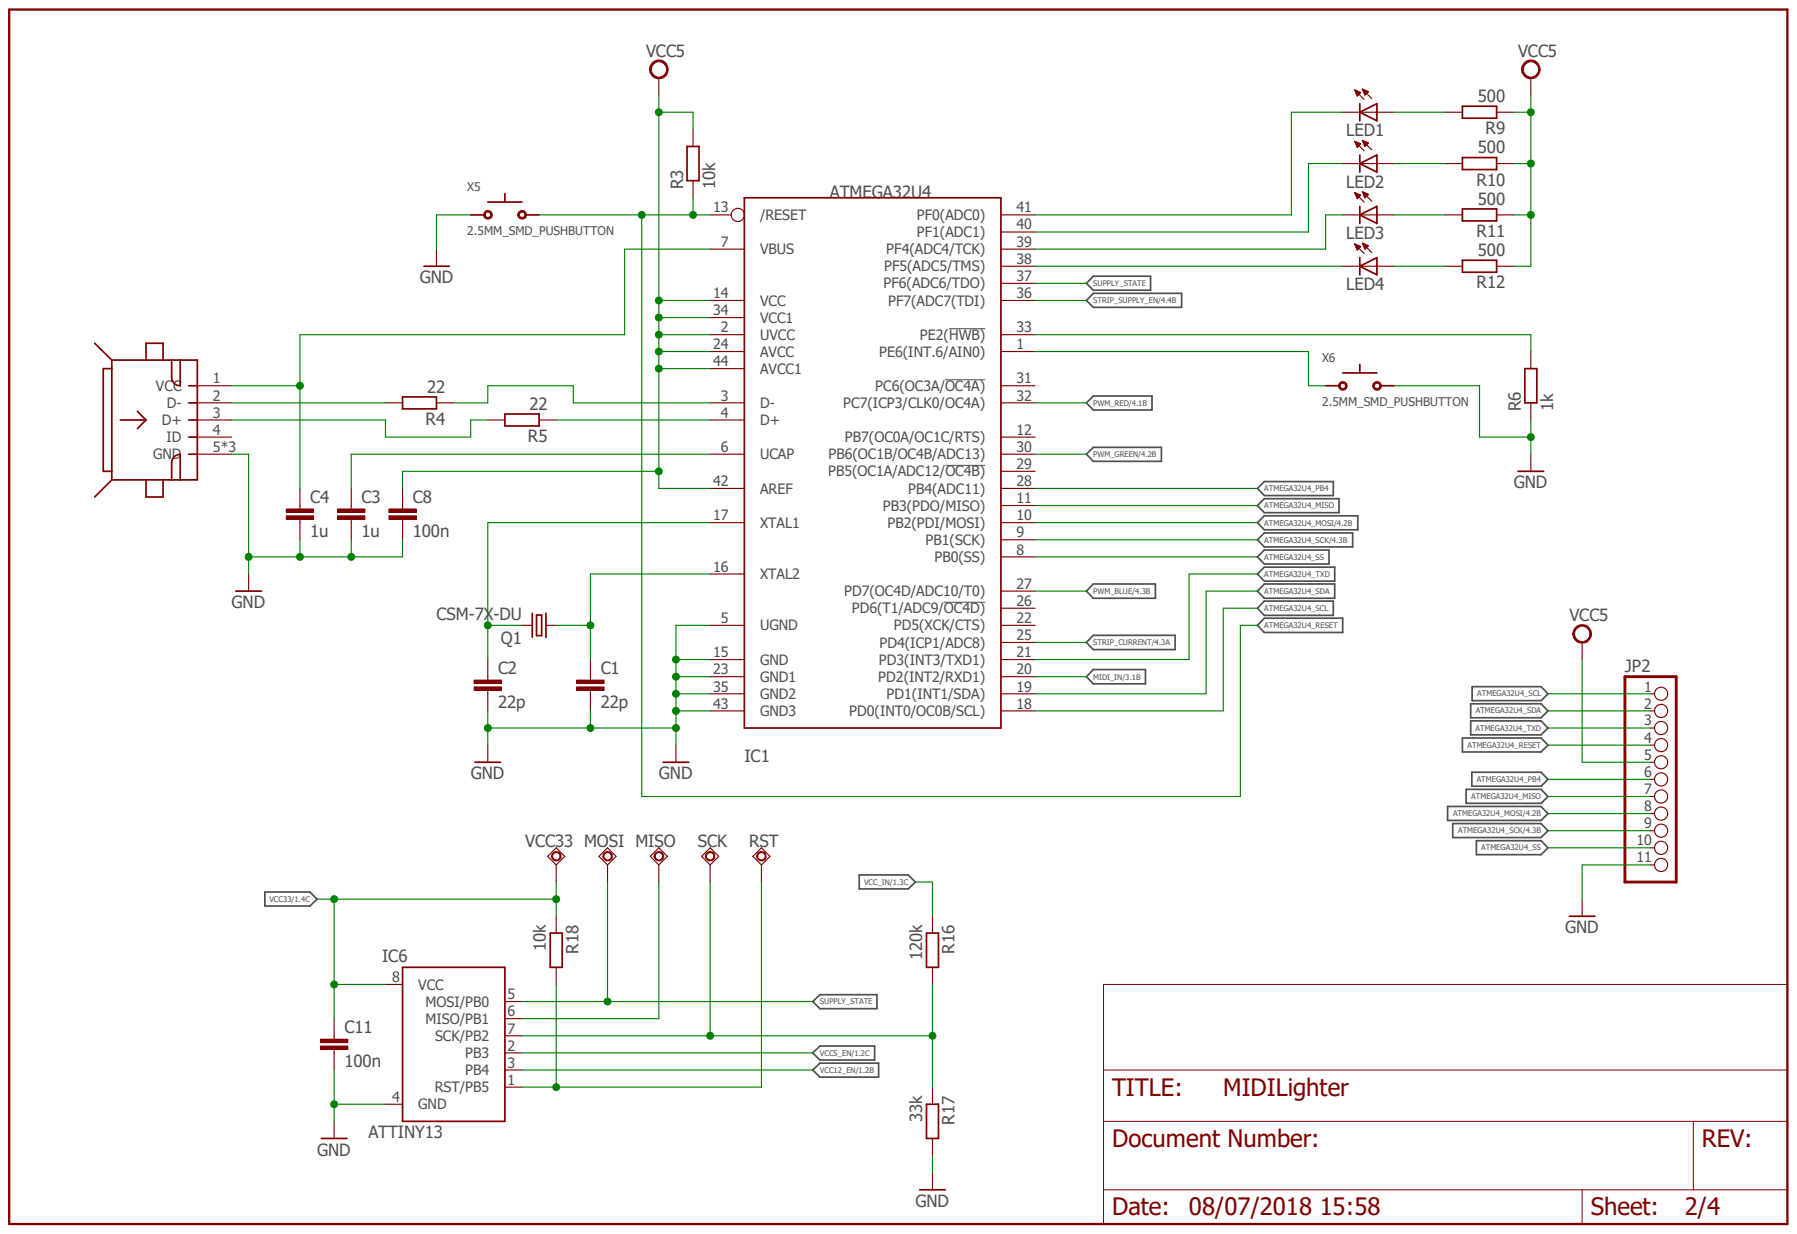
[picture p22: page 2]

UCAP 6

AREF 42

XTAL2 16

UGND 5

VCC33 MOSI MISO SCK RST

Document Number: | REV:

Date: 08/07/2018 15:58 | Sheet: 2/4

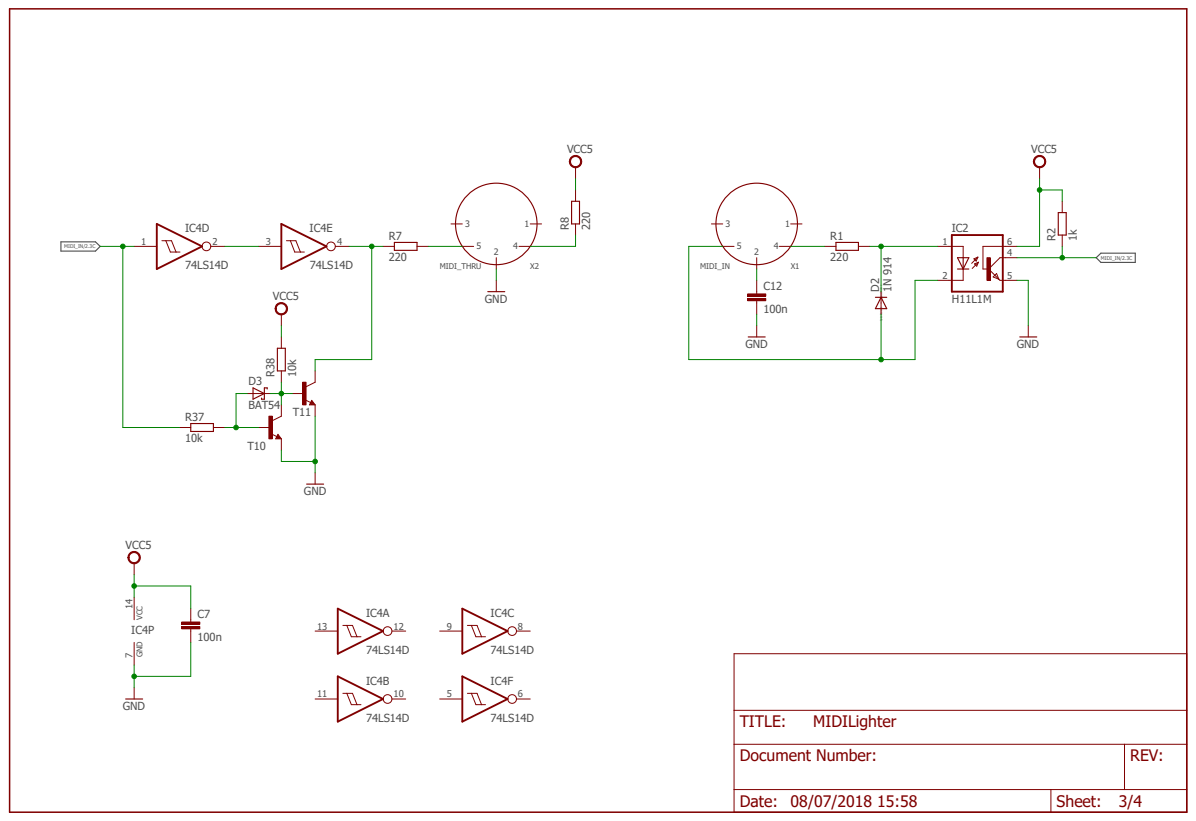
[picture p23: page 3]

Document Number: | REV:

Date: 08/07/2018 15:58 | Sheet: 3/4

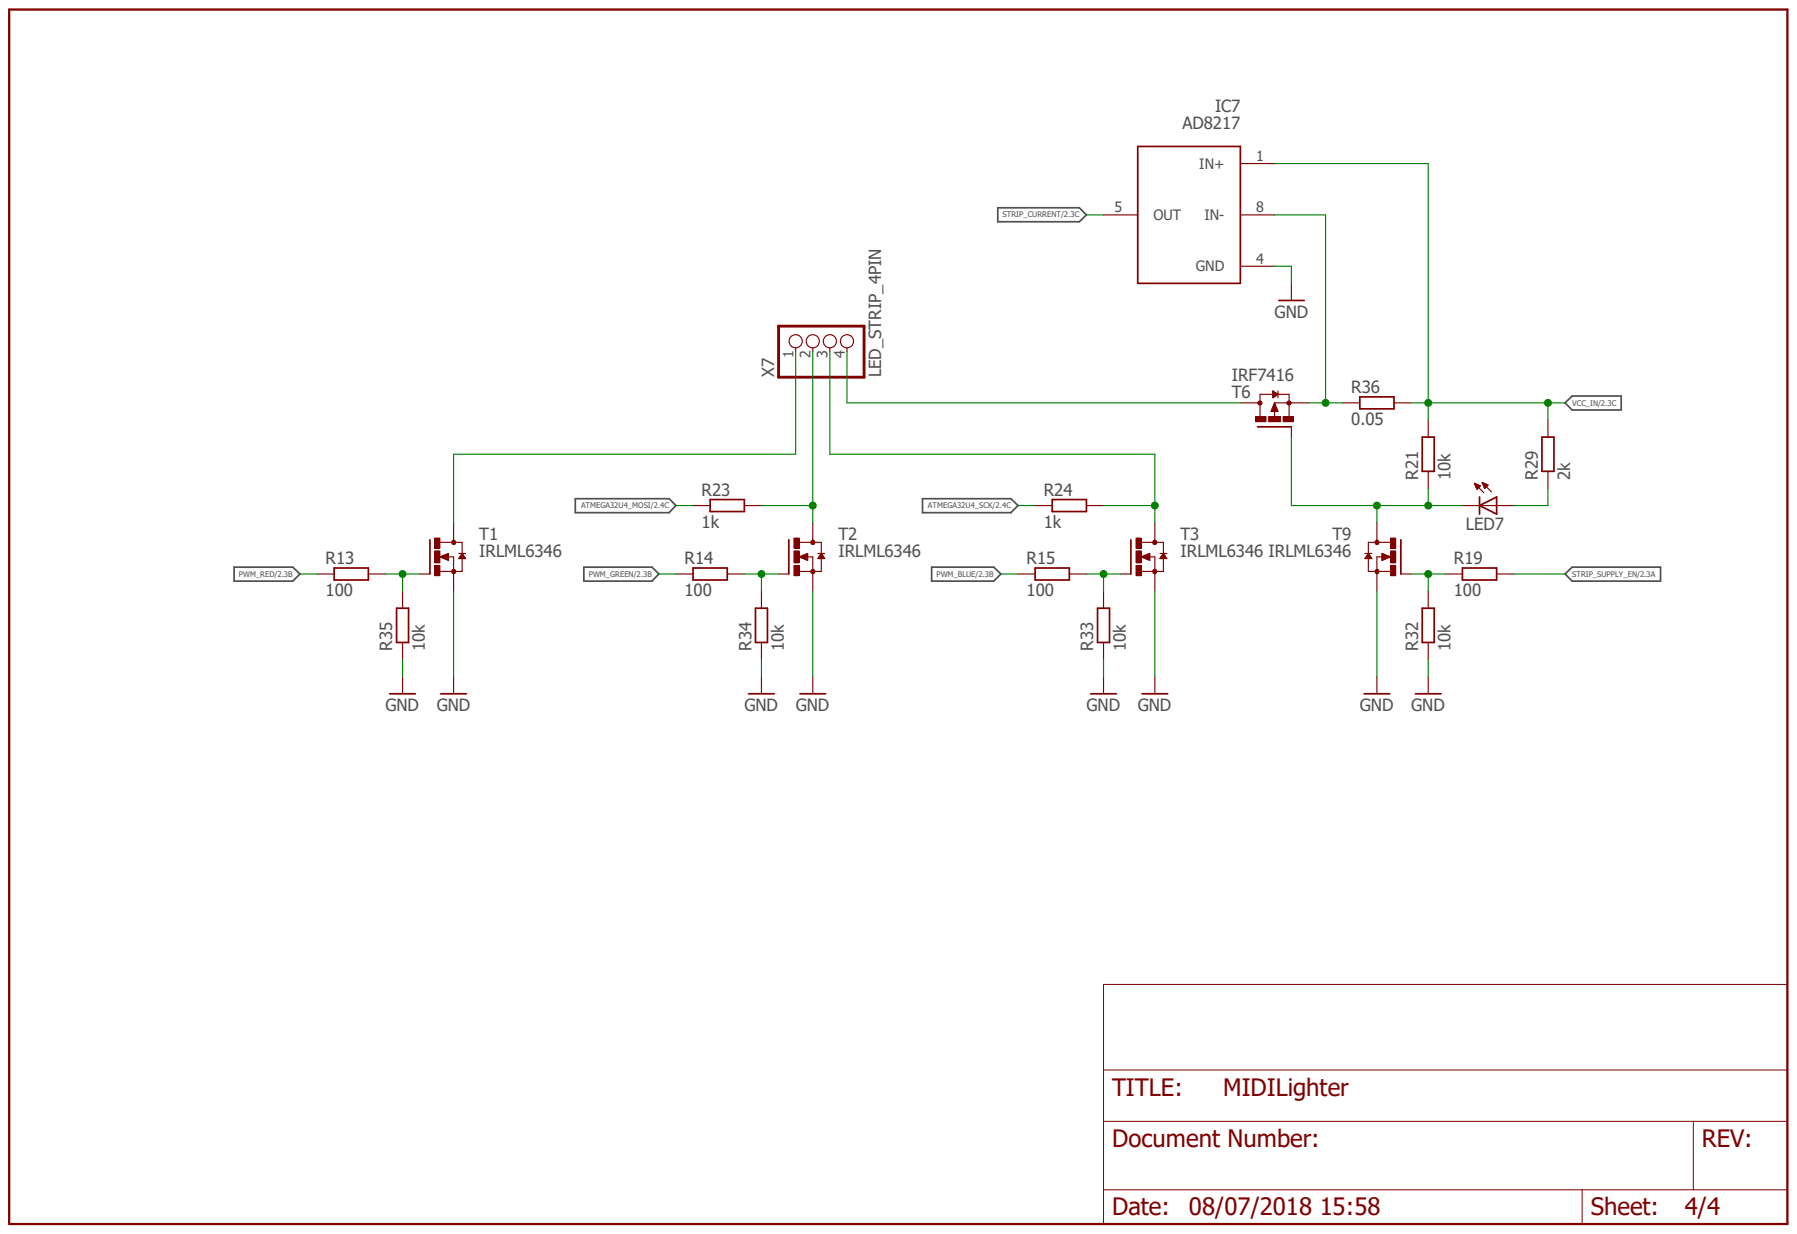
[picture p24: page 4]

Document Number: | REV:

Date: 08/07/2018 15:58 | Sheet: 4/4
