MrChros/MIDI_Lighter/Doc/Export/MIDI_Lighter_Breadboard.pdf

# MIDI Optokoppler

# (H11L1M)

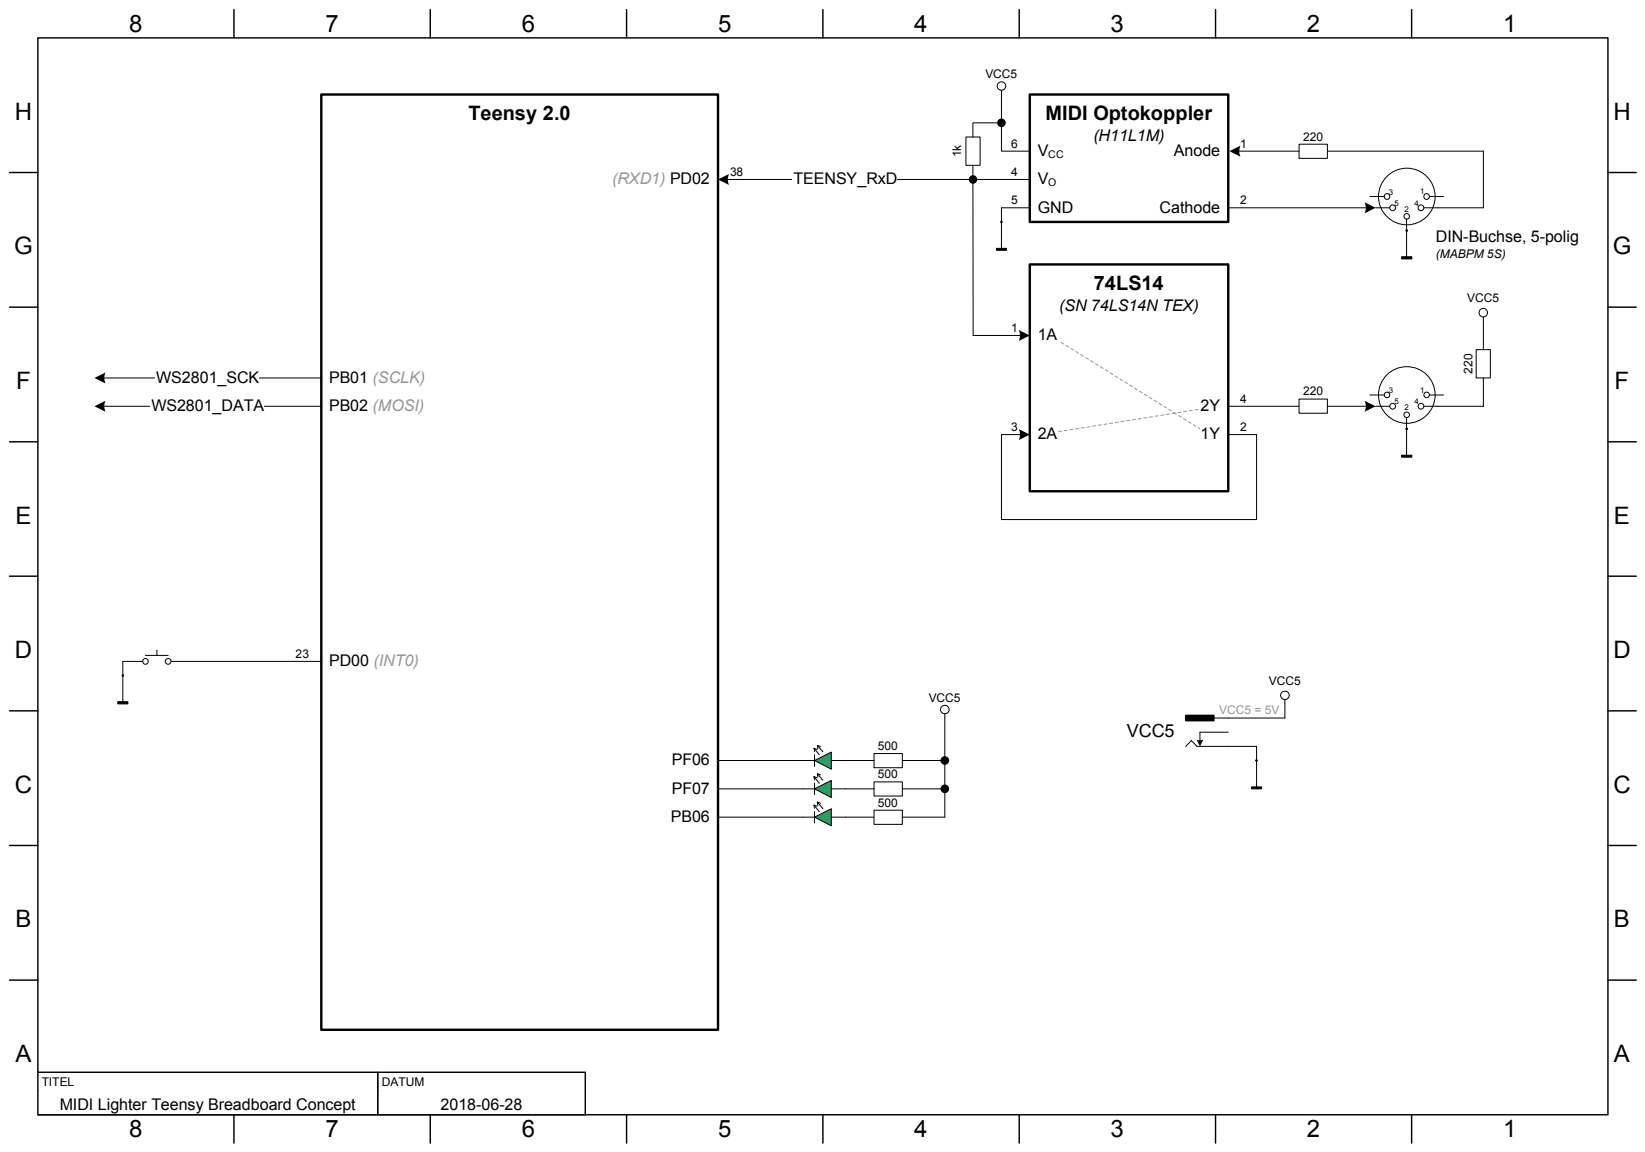
[picture p25: page 1]
TEENSY_RxD; Anode; GND; Cathode; VCC; VCC5; (SN 74LS14N TEX); Teensy 2.0; (RXD1) PD02; WS2801_SCK; PB01 (SCLK); WS2801_DATA; PB02 (MOSI); 23 PD00 (INT0); VCC5 = 5V; DATUM

DIN-Buchse, 5-polig
(MABPM 5S)

TITEL
MIDI Lighter Teensy Breadboard Concept

H

G

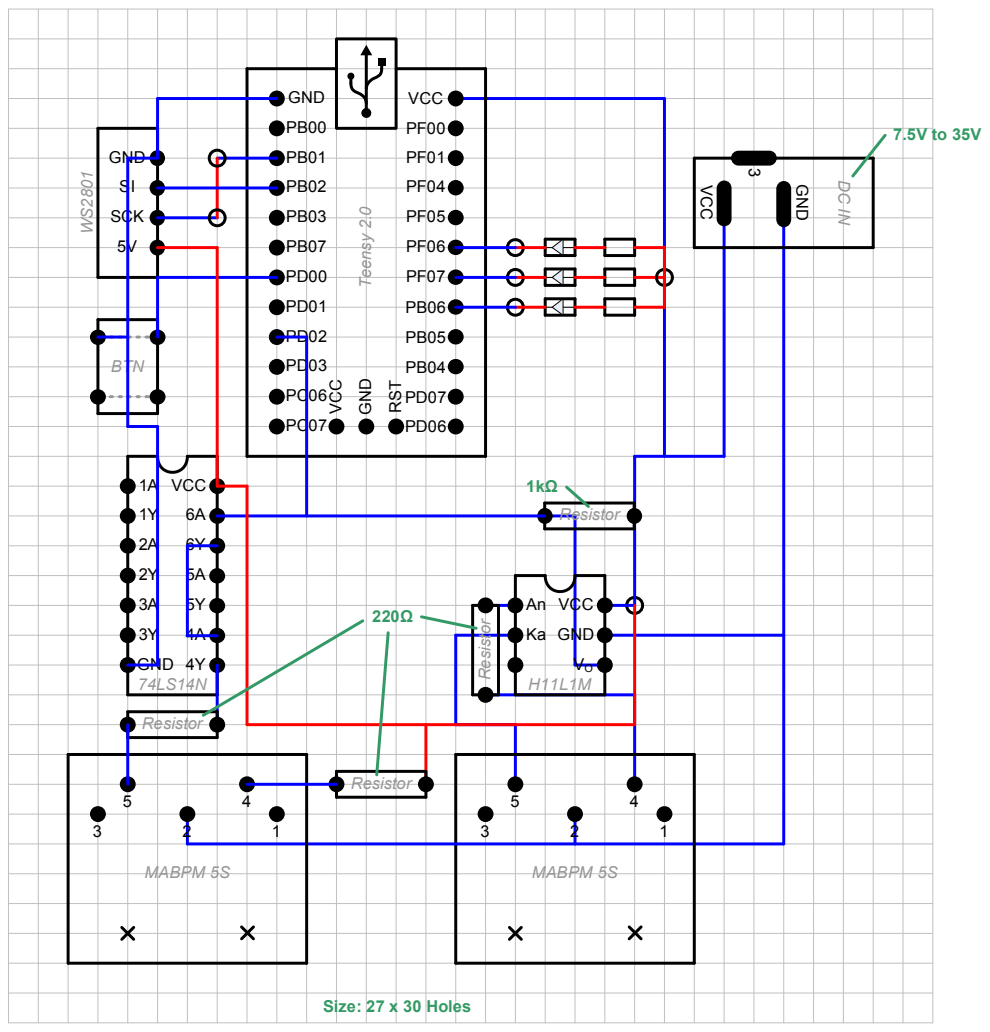
[picture p26: page 2]
VCC; GND; RST; Teensy 2.0; Resistor; Size: 27 x; Holes

GND | VCC

GND | PB01 | PF00 PF01

SCK | | | | PB03 | PF05

BTN | PD03 | PB04

1A | VCC | | | | 1kΩ

Resistor

3A | | 5Y | | | An | VCC
3Y | 4A | 220Ω | Ka | GND

GND | 4Y | | | | VO
74LS14N | H11L1M

MABPM 5S | | | | | MABPM 5S

MIDI Lighter Teensy Breadboard Layout

H

G

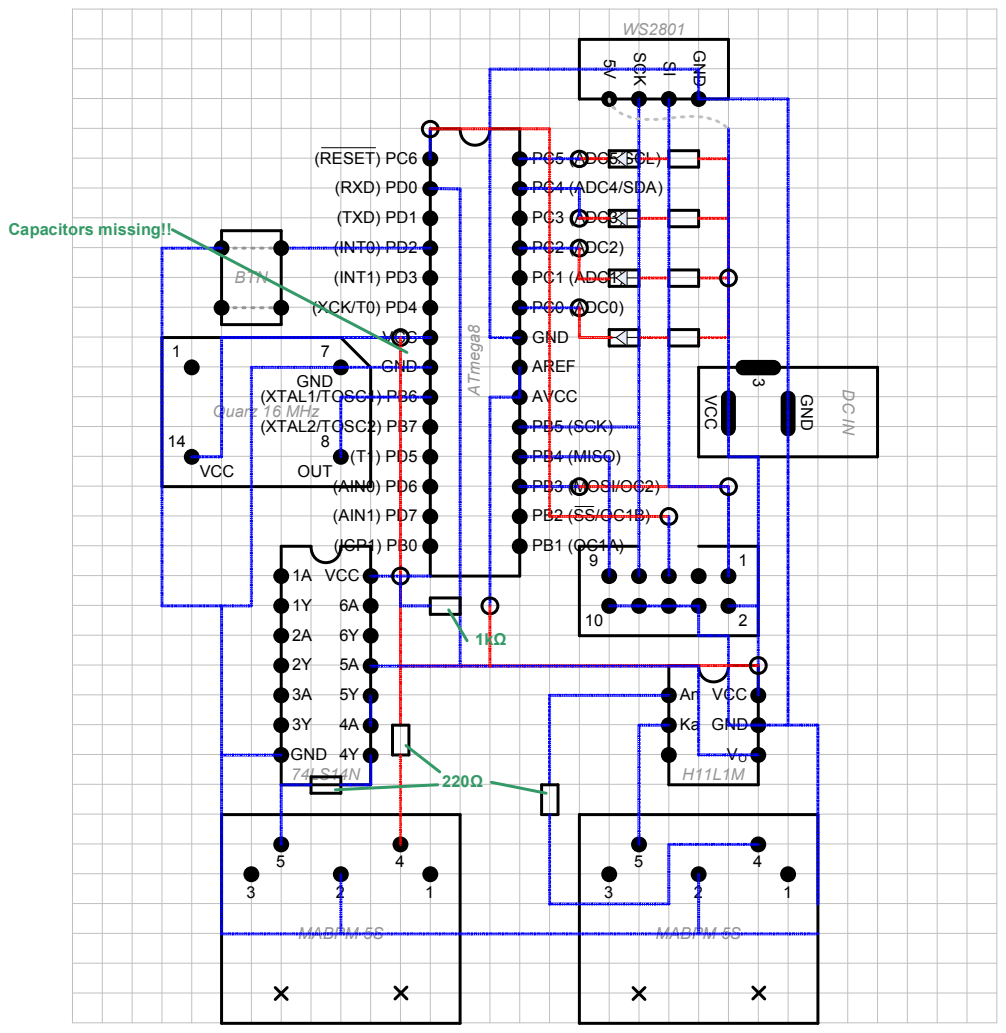
[picture p27: page 3]
ATmega8; VCC; GND; SCK; Capacitors missing!!

(RESET) PC6

PC5 (ADC5/SCL)

(RXD) PD0 | | PC4 (ADC4/SDA)

(TXD) PD1 | | PC3 (ADC3)

(INT0) PD2 | | PC2 (ADC2)

BTN | (INT1) PD3 | | PC1 (ADC1)

(XCK/T0) PD4 | | | PC0 (ADC0)

1 7 | | | | | | | GND | AREF

VCC | GND

(XTAL1/TOSC1) PB6 | GND | | | | AVCC

Quarz 16 MHz | (XTAL2/TOSC2) PB7 | | | | | PB5 (SCK)

14 8 | | | | | | (T1) PD5 | | PB4 (MISO)

VCC | | | OUT | | (AIN0) PD6 | | PB3 (MOSI/OC2)

(ICP1) PB0 | PB2 (SS/OC1B) PB1 (OC1A)
(AIN1) PD7

1A | VCC | | | 9 | 1

1Y | | 6A
2A | 6Y | | 10 | | | 2
2Y | 5A | 1kΩ

3A | 5Y | | | An | VCC

3Y | 4A | | Ka | GND

GND | 4Y | | | | | VO
74LS14N | | 220Ω | H11L1M

MABPM 5S | | | | | MABPM 5S

MIDI Lighter ATmega8 Breadboard Layout
