MrChros/MIDI_Lighter/Doc/Export/MIDI_Lighter_PCB_Layout_12V_v1.0.pdf

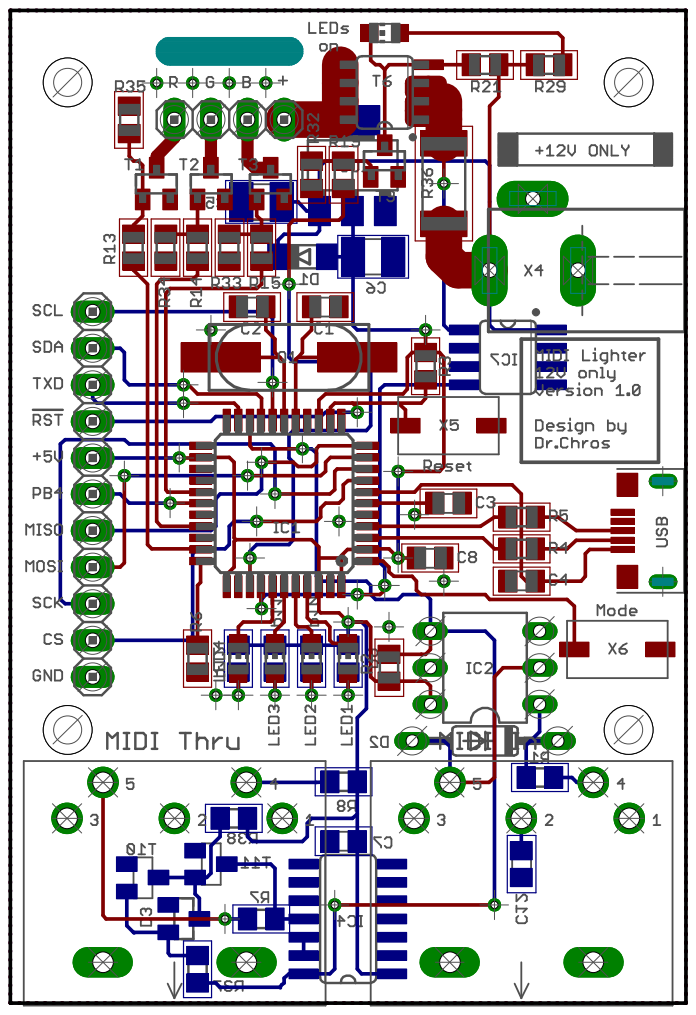
[picture p28: page 1]

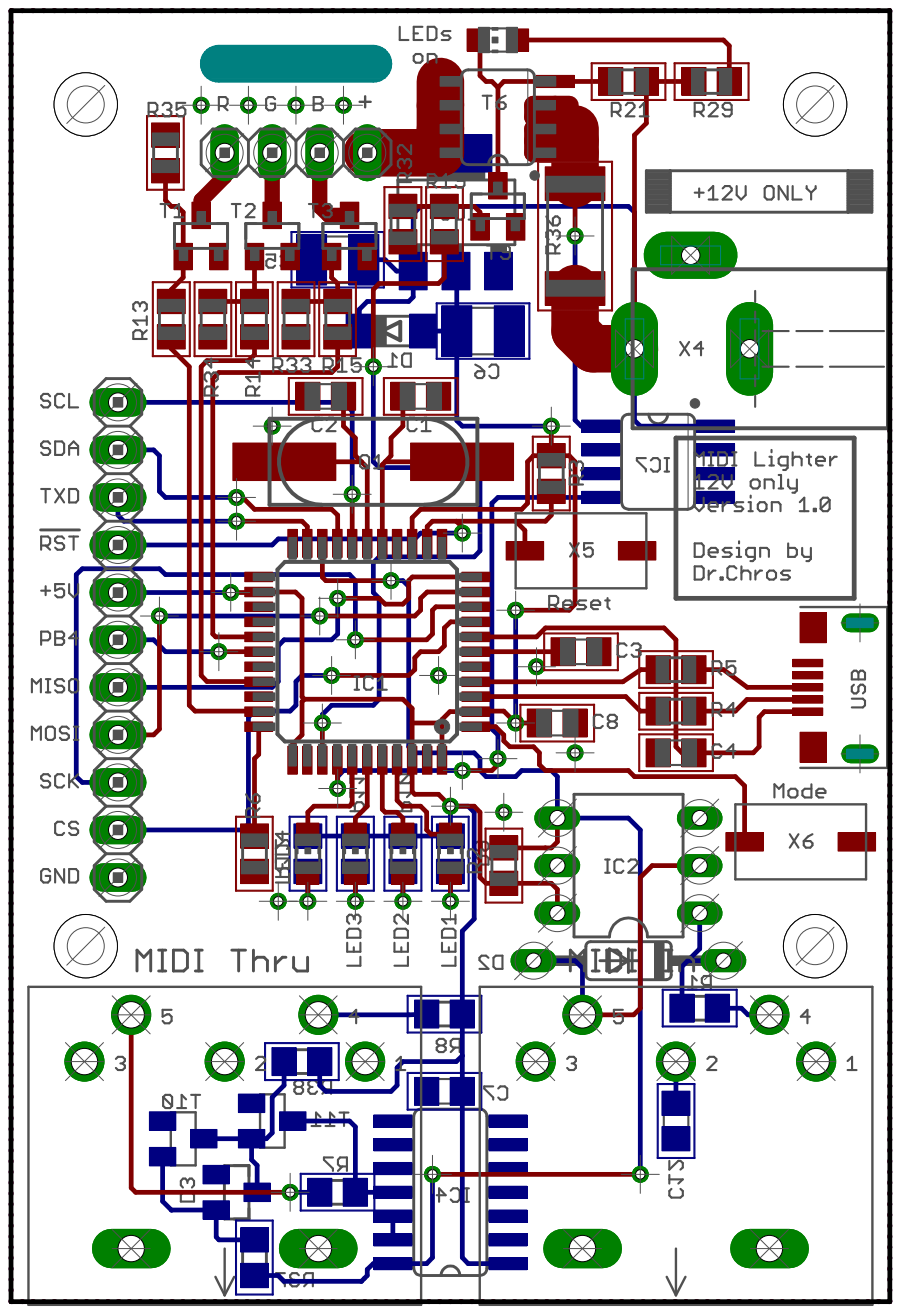
[picture p29: page 2]

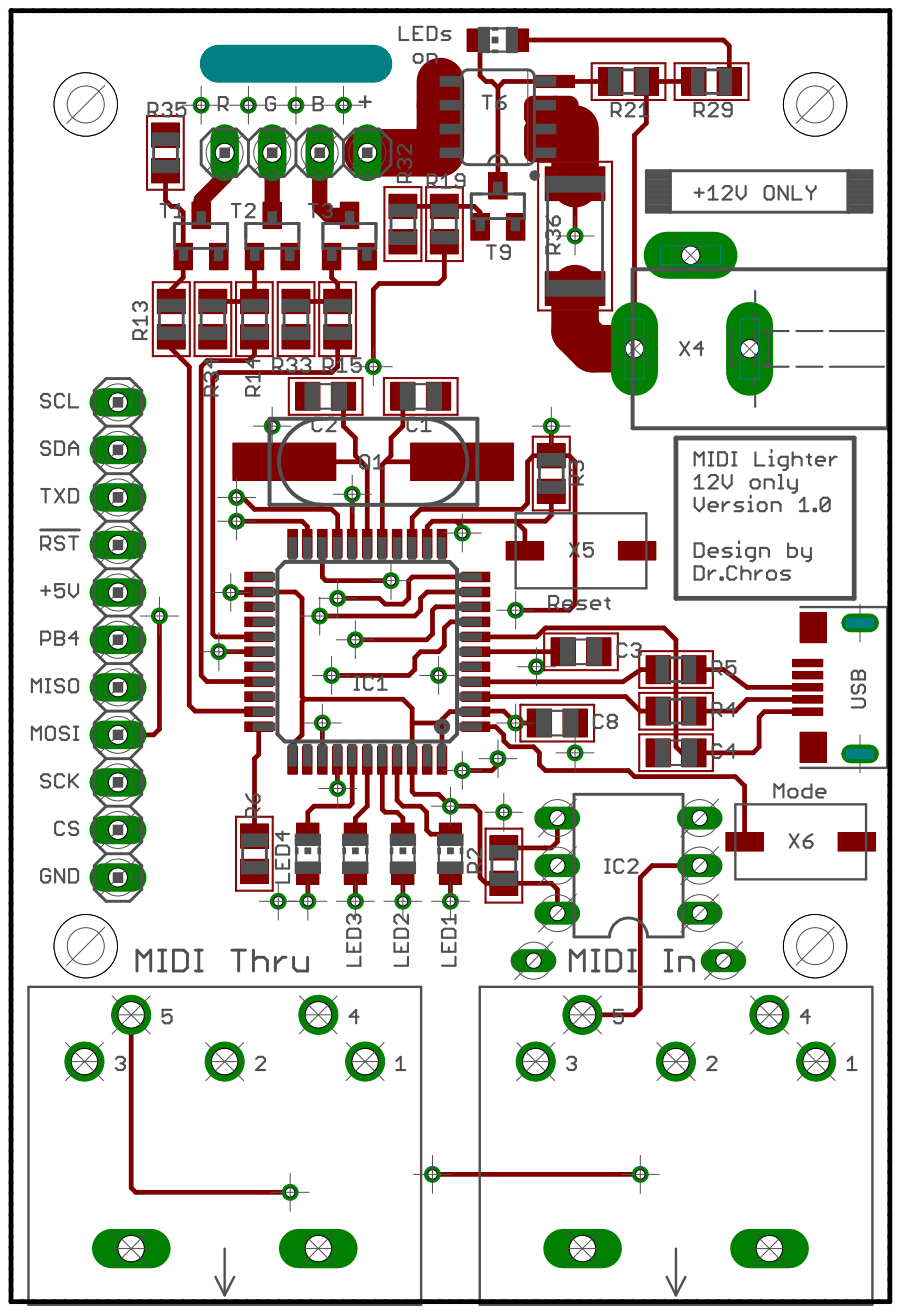
[picture p30: page 3]

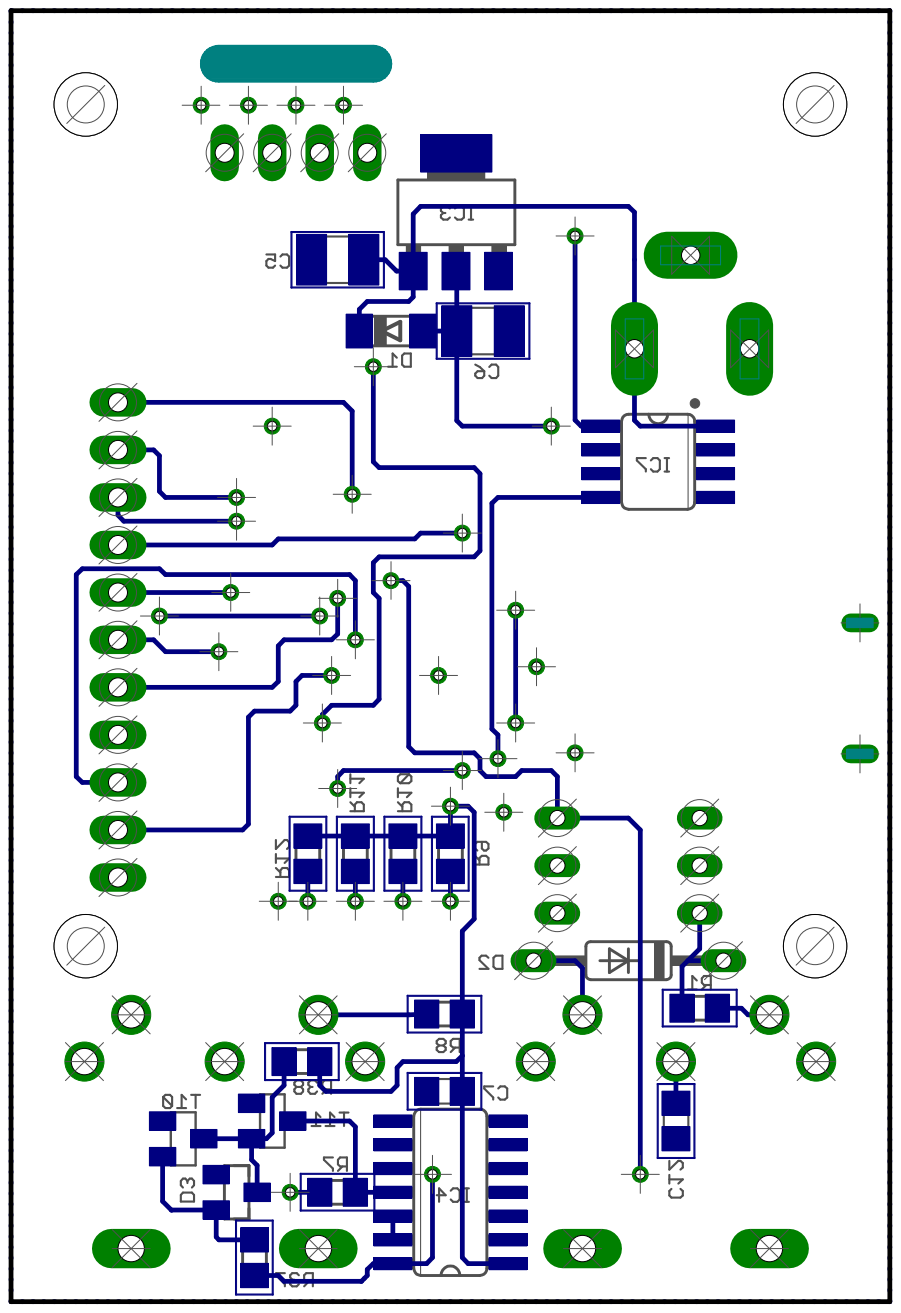
[picture p31: page 4]
