MrChros/MIDI_Lighter/PCB/MIDI_Lighter_Multi-Voltage.brd

## EAGLE design PCB/MIDI_Lighter_Multi-Voltage.brd (2022-03-05)

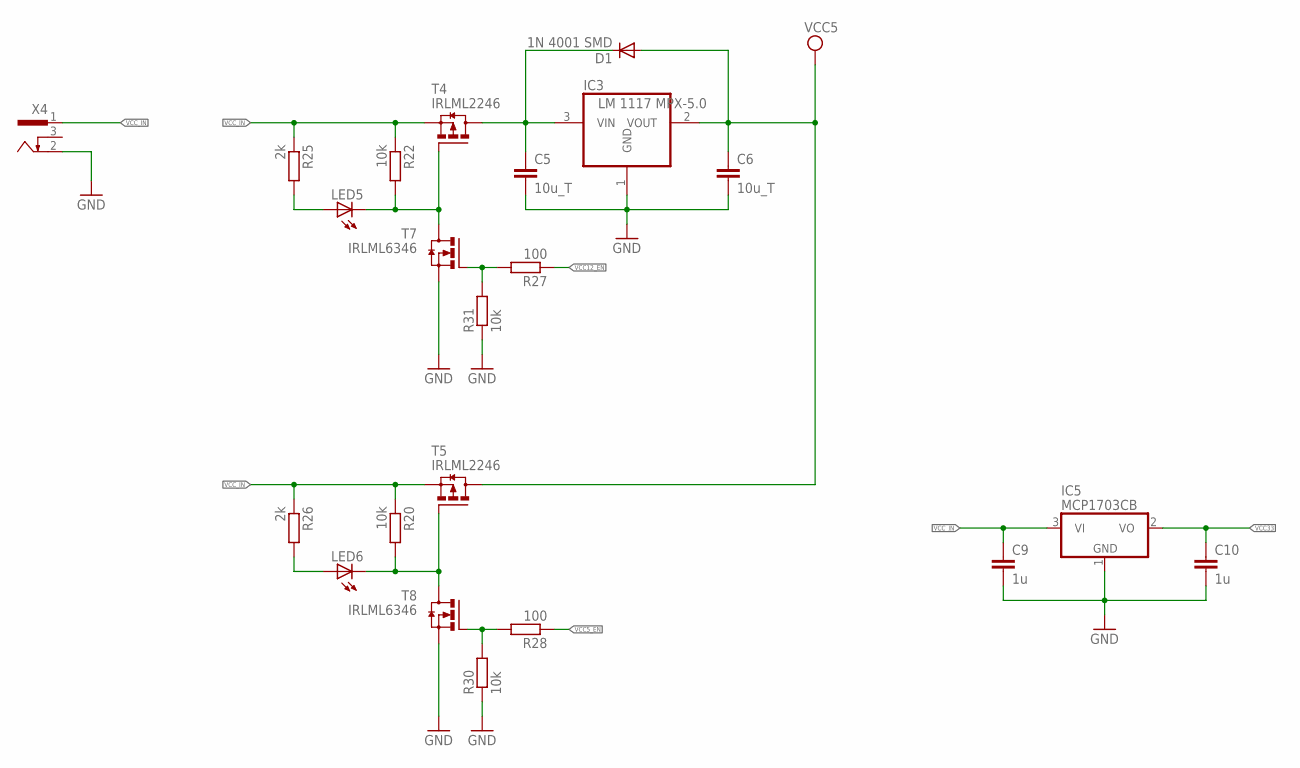
[picture p36: schematic MIDI_Lighter_Multi-Voltage.sch, sheet 1, POWER SUPPLY]

Parts:
C5, C6: 10u_T; C1210
C9, C10: 1u; C0805
D1: 1N 4001 SMD; MINIMELF
IC3: LM 1117 MPX-5.0; SOT223
IC5: MCP1703CB; SOT23
LED5, LED6: LEDCHIP-LED0805; CHIP-LED0805
R20, R22, R30, R31: 10k; R0805
R25, R26: 2k; R0805
R27, R28: 100; R0805
T4, T5: IRLML2246; SOT23
T7, T8: IRLML6346; SOT23
X4: 733980-62

Connections:
GND: C5.2, C6.2, C9.2, C10.2, IC3.1 (GND), IC5.1 (GND), R30.1, R31.1, T7.2 (S), T8.2 (S), X4.2; also elsewhere on the board
unnamed: C5.1, D1.C, IC3.3 (VIN), T4.3 (D)
unnamed: LED5.C, R22.2, T4.1 (G), T7.3 (D)
unnamed: LED6.C, R20.2, T5.1 (G), T8.3 (D)
unnamed: LED6.A, R26.2
unnamed: LED5.A, R25.2
unnamed: R27.2, R31.2, T7.1 (G)
unnamed: R28.2, R30.2, T8.1 (G)
VCC: C6.1, D1.A, IC3.2 (VOUT), T5.3 (D); also elsewhere on the board
VCC5_EN: R28.1; also elsewhere on the board
VCC12_EN: R27.1; also elsewhere on the board
VCC33: C10.1, IC5.2 (VO); also elsewhere on the board
VCC_IN: C9.1, IC5.3 (VI), R20.1, R22.1, R25.1, R26.1, T4.2 (S), T5.2 (S), X4.1; also elsewhere on the board

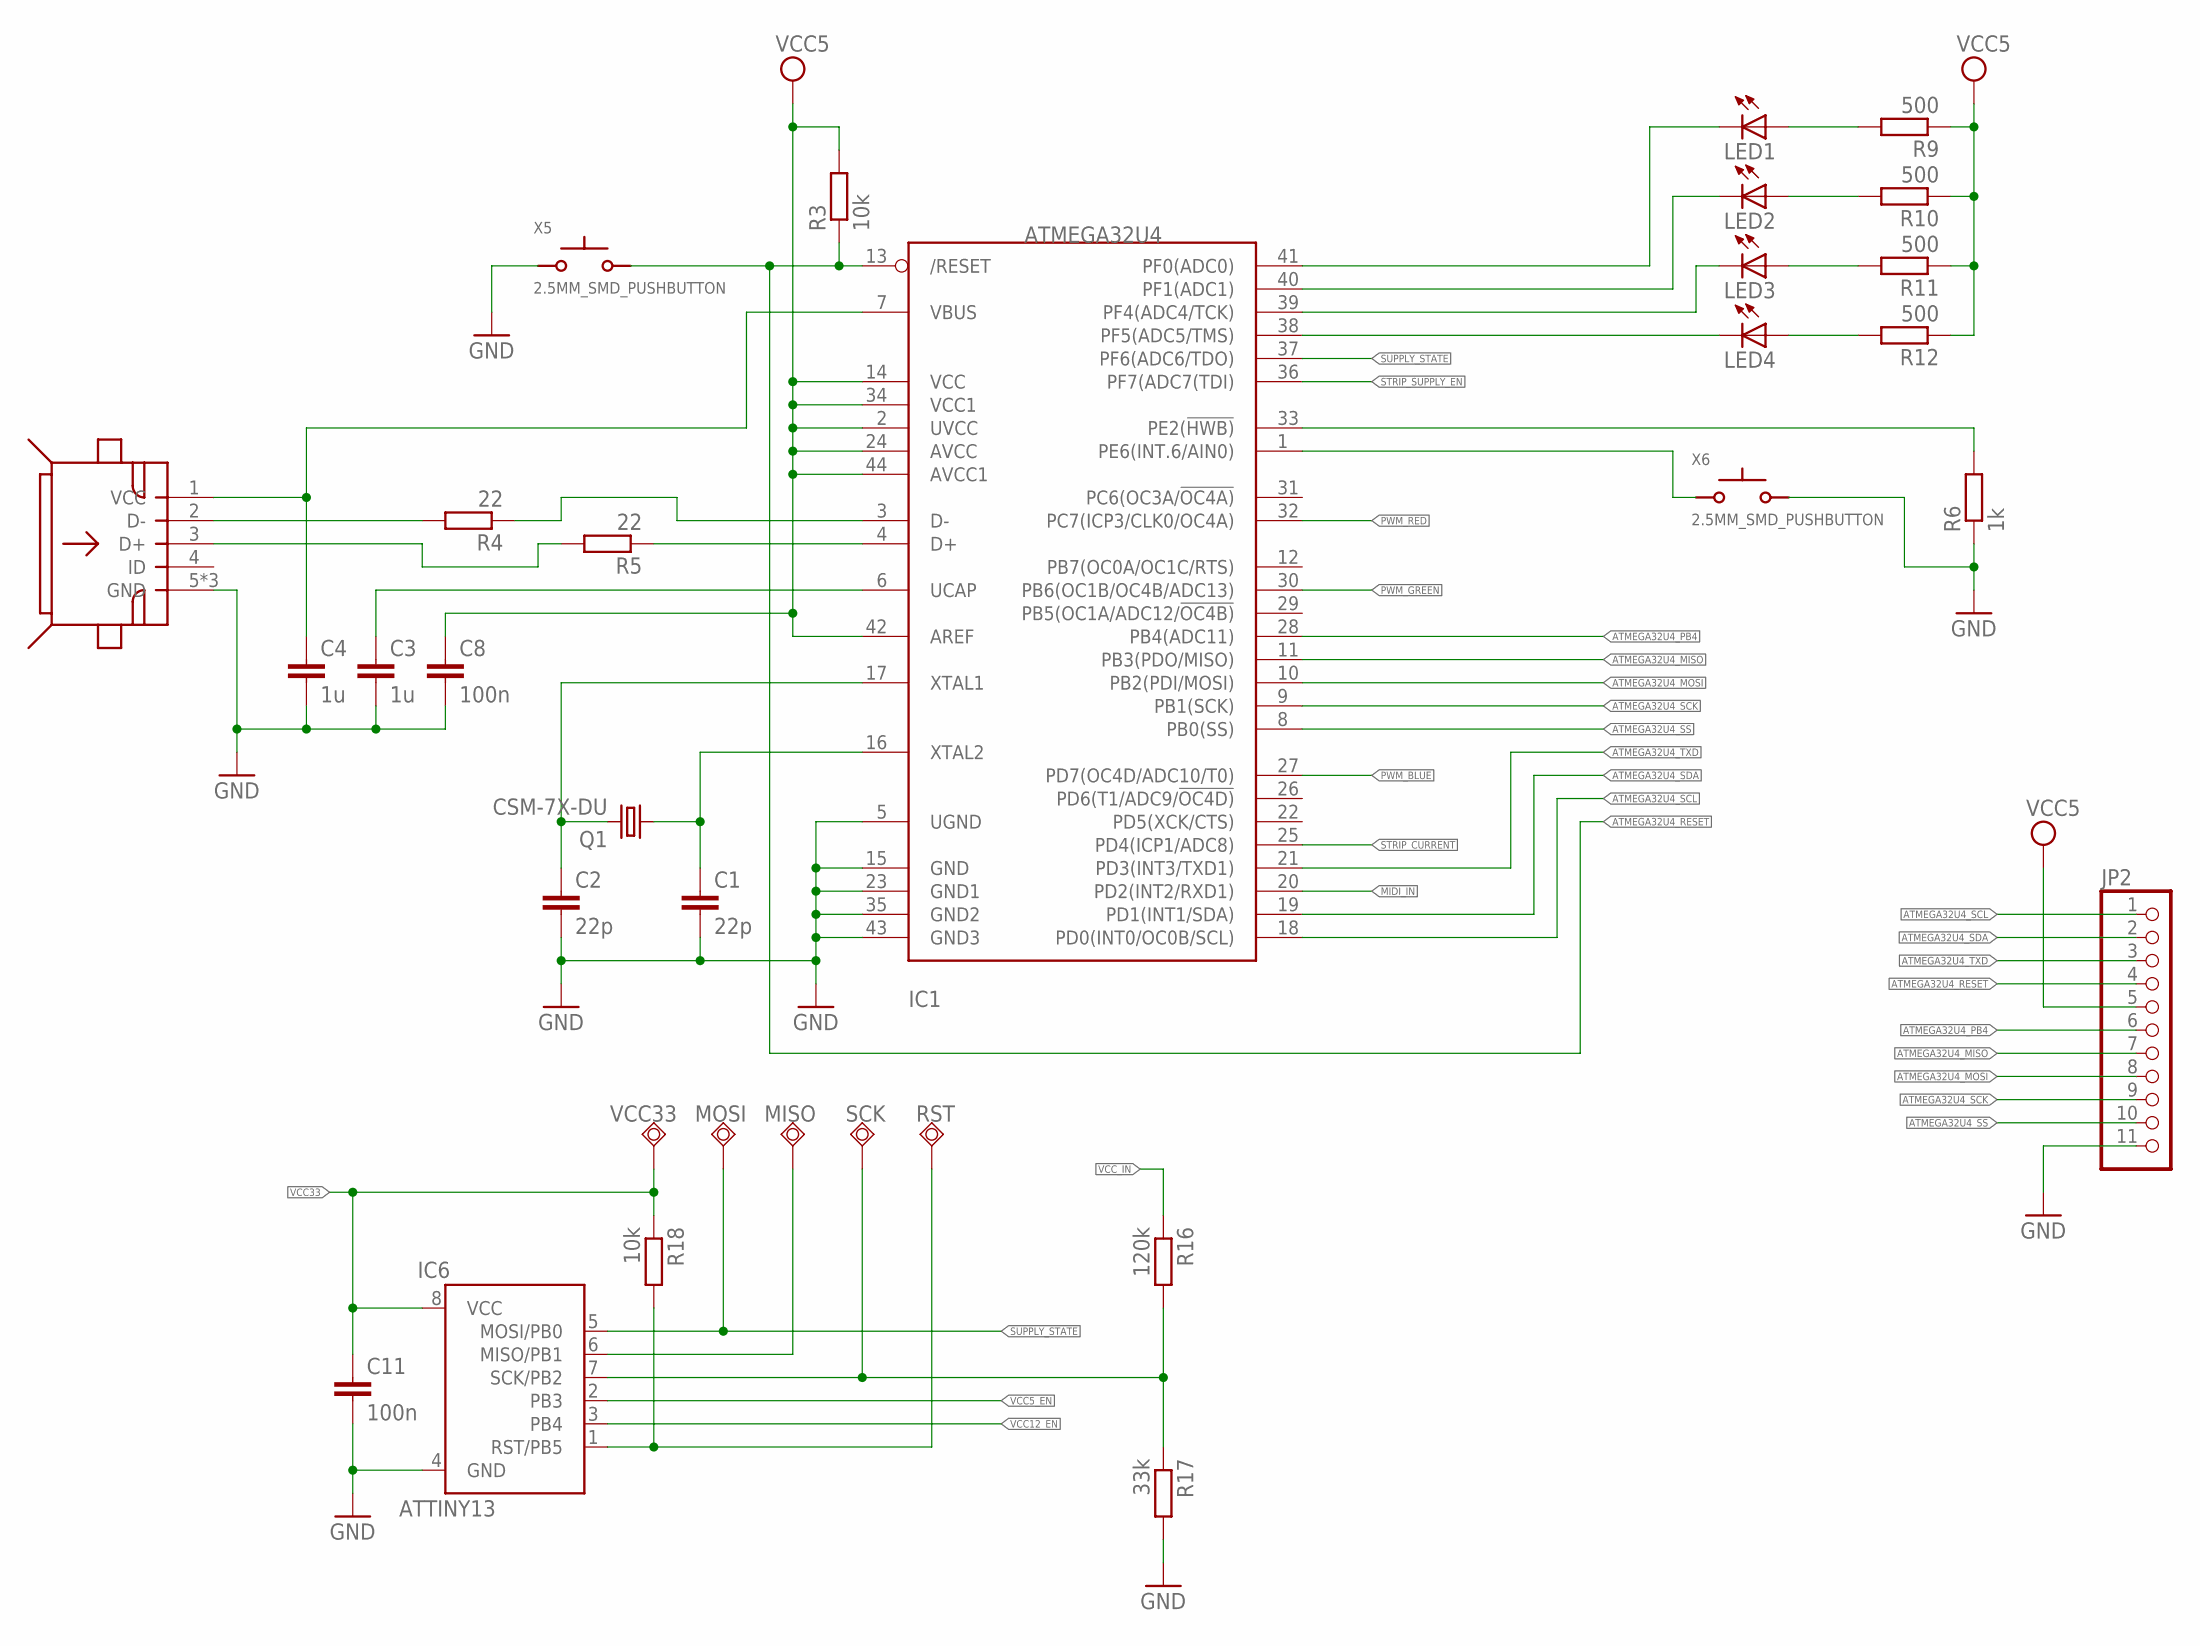
[picture p37: schematic MIDI_Lighter_Multi-Voltage.sch, sheet 2, MCU]

Parts:
C1, C2: 22p; C0805
C3, C4: 1u; C0805
C8, C11: 100n; C0805
IC1: ATMEGA32U4; TQFP44
IC6: ATTINY13; SO08
JP2: PINHD-1X11; 1X11
LED1, LED2, LED3, LED4: LEDCHIP-LED0805; CHIP-LED0805
MISO: TPSQTP13R; TP13R
MOSI: TPSQTP13R; TP13R
Q1: CSM-7X-DU
R3, R18: 10k; R0805
R4, R5: 22; R0805
R6: 1k; R0805
R9, R10, R11, R12: 500; R0805
R16: 120k; R0805
R17: 33k; R0805
RST: TPSQTP13R; TP13R
SCK: TPSQTP13R; TP13R
VCC33: TPSQTP13R; TP13R
X3: USB_MICRO_BUCHSE_LCSC
X5, X6: 2.5MM_SMD_PUSHBUTTON

Connections:
ATMEGA32U4_MISO: IC1.11 (PB3(PDO/MISO)), JP2.7
ATMEGA32U4_MOSI: IC1.10 (PB2(PDI/MOSI)), JP2.8; also elsewhere on the board
ATMEGA32U4_PB4: IC1.28 (PB4(ADC11)), JP2.6
ATMEGA32U4_RESET: IC1.13 (/RESET), JP2.4, R3.1, X5.2
ATMEGA32U4_SCK: IC1.9 (PB1(SCK)), JP2.9; also elsewhere on the board
ATMEGA32U4_SCL: IC1.18 (PD0(INT0/OC0B/SCL)), JP2.1
ATMEGA32U4_SDA: IC1.19 (PD1(INT1/SDA)), JP2.2
ATMEGA32U4_SS: IC1.8 (PB0(SS)), JP2.10
ATMEGA32U4_TXD: IC1.21 (PD3(INT3/TXD1)), JP2.3
GND: C1.2, C2.2, C3.2, C4.2, C8.2, C11.2, IC1.5 (UGND), IC1.15 (GND), IC1.23 (GND1), IC1.35 (GND2), IC1.43 (GND3), IC6.4 (GND), JP2.11, R6.1, R17.2, X3.5 (GND), X3.GND1 (GND), X3.GND2 (GND), X5.1, X6.2; also elsewhere on the board
MIDI_IN: IC1.20 (PD2(INT2/RXD1)); also elsewhere on the board
unnamed: R4.2, X3.2 (D-)
unnamed: IC1.3 (D-), R4.1
unnamed: C1.1, IC1.16 (XTAL2), Q1.1
unnamed: C2.1, IC1.17 (XTAL1), Q1.2
unnamed: C3.1, IC1.6 (UCAP)
unnamed: R5.2, X3.3 (D+)
unnamed: IC1.4 (D+), R5.1
unnamed: IC1.33 (PE2(!HWB)), R6.2
unnamed: IC1.41 (PF0(ADC0)), LED1.C
unnamed: IC1.40 (PF1(ADC1)), LED2.C
unnamed: IC1.39 (PF4(ADC4/TCK)), LED3.C
unnamed: IC1.38 (PF5(ADC5/TMS)), LED4.C
unnamed: IC1.1 (PE6(INT.6/AIN0)), X6.1
unnamed: LED1.A, R9.2
unnamed: LED2.A, R10.2
unnamed: LED3.A, R11.2
unnamed: LED4.A, R12.2
unnamed: IC6.1 (RST/PB5), R18.2, RST.TP
unnamed: IC6.6 (MISO/PB1), MISO.TP
PWM_BLUE: IC1.27 (PD7(OC4D/ADC10/T0)); also elsewhere on the board
PWM_GREEN: IC1.30 (PB6(OC1B/OC4B/ADC13)); also elsewhere on the board
PWM_RED: IC1.32 (PC7(ICP3/CLK0/OC4A)); also elsewhere on the board
STRIP_CURRENT: IC1.25 (PD4(ICP1/ADC8)); also elsewhere on the board
STRIP_SUPPLY_EN: IC1.36 (PF7(ADC7(TDI)); also elsewhere on the board
SUPPLY_STATE: IC1.37 (PF6(ADC6/TDO)), IC6.5 (MOSI/PB0), MOSI.TP
VCC: C8.1, IC1.2 (UVCC), IC1.14 (VCC), IC1.24 (AVCC), IC1.34 (VCC1), IC1.42 (AREF), IC1.44 (AVCC1), JP2.5, R3.2, R9.1, R10.1, R11.1, R12.1; also elsewhere on the board
VCC5_EN: IC6.2 (PB3); also elsewhere on the board
VCC12_EN: IC6.3 (PB4); also elsewhere on the board
VCC33: C11.1, IC6.8 (VCC), R18.1, VCC33.TP; also elsewhere on the board
VCC_IN: R16.1; also elsewhere on the board
VCC_USB: C4.1, IC1.7 (VBUS), X3.1 (VCC)
VOLTAGE_READ: IC6.7 (SCK/PB2), R16.2, R17.1, SCK.TP

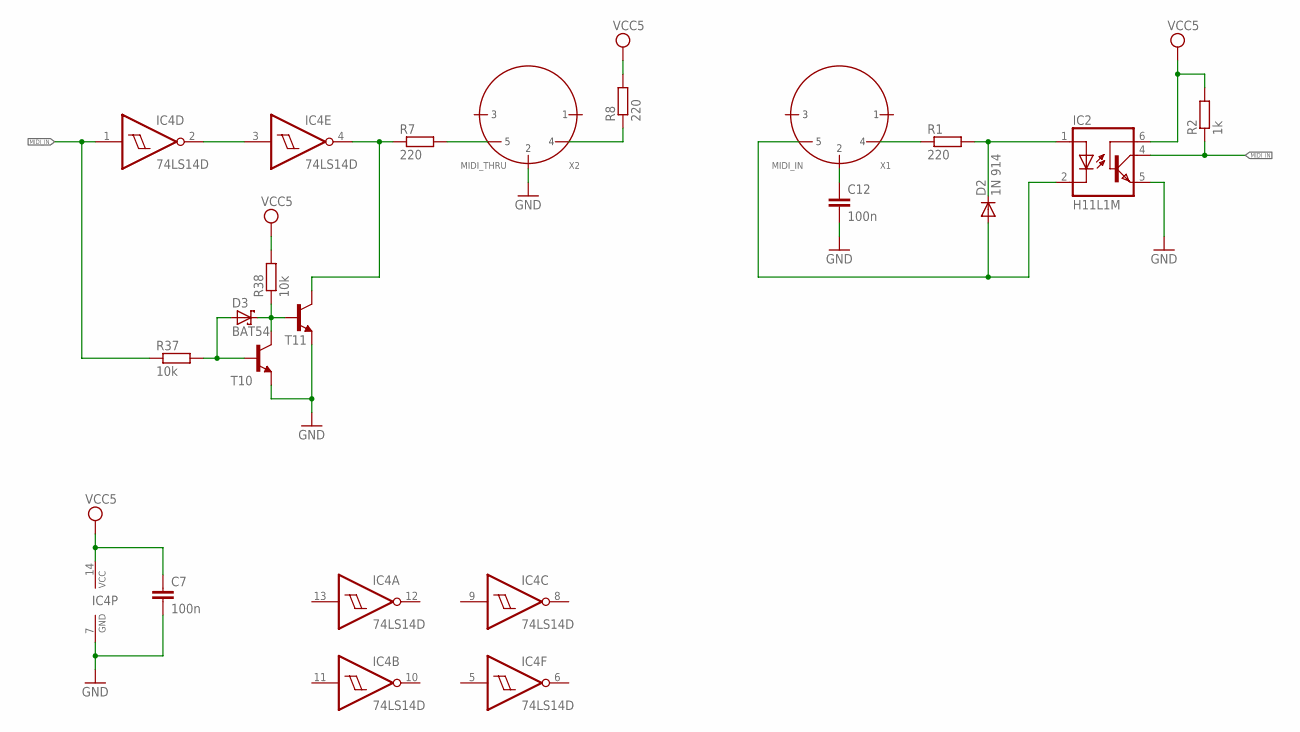
[picture p38: schematic MIDI_Lighter_Multi-Voltage.sch, sheet 3, MIDI]

Parts:
C7, C12: 100n; C0805
D2: 1N 914; DO35-10
D3: BAT54; SOT23
IC2: H11L1M; DIL06
IC4: 74LS14D; SO14
R1, R7, R8: 220; R0805
R2: 1k; R0805
R37, R38: 10k; R0805
T10, T11: BC847CLT1-NPN-SOT23-BEC; SOT23-BEC
X1: MIDI_IN; DIN_PLUG_5_PINS
X2: MIDI_THRU; DIN_PLUG_5_PINS

Connections:
GND: C7.2, C12.2, IC2.5 (GND), IC4.7 (GND), T10.E, T11.E, X2.2; also elsewhere on the board
MIDI_IN: IC2.4 (VO), IC4.1 (I), R2.1, R37.1; also elsewhere on the board
unnamed: D2.C, IC2.1 (A), R1.2
unnamed: R1.1, X1.4
unnamed: D2.A, IC2.2 (C), X1.5
unnamed: IC4.2 (O), IC4.3 (I)
unnamed: R7.2, X2.5
unnamed: R8.1, X2.4
unnamed: C12.1, X1.2
unnamed: D3.1 (A), R37.2, T10.B
unnamed: D3.3 (C), R38.1, T10.C, T11.B
unnamed: IC4.4 (O), R7.1, T11.C
VCC: C7.1, IC2.6 (VCC), IC4.14 (VCC), R2.2, R8.2, R38.2; also elsewhere on the board

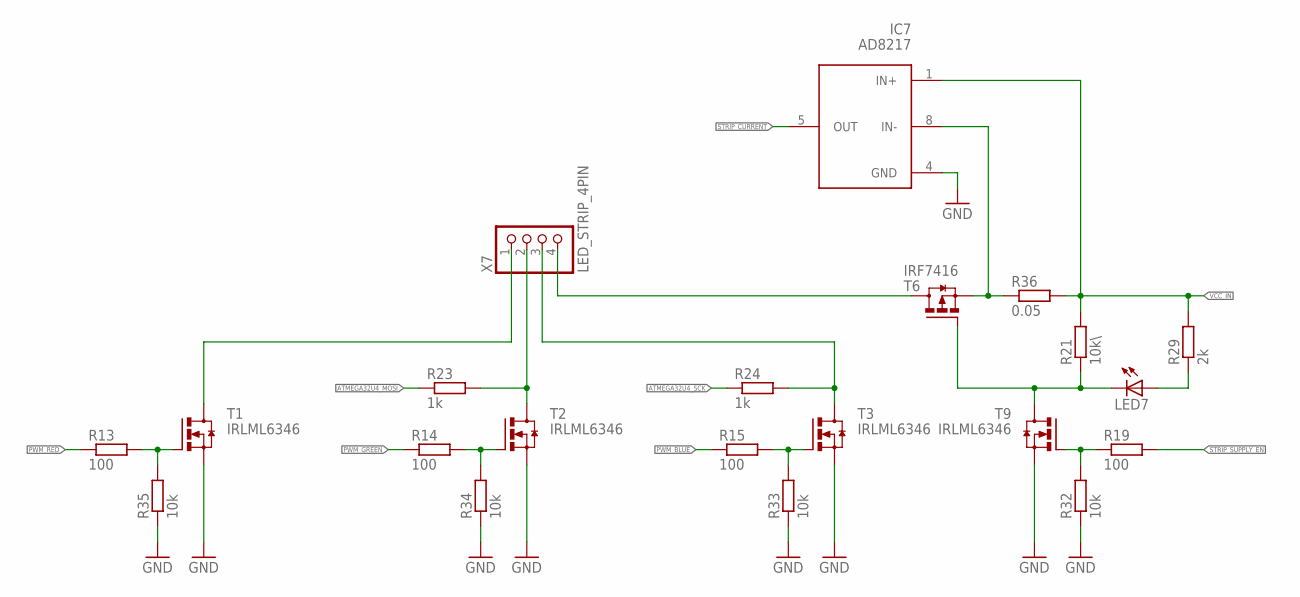
[picture p39: schematic MIDI_Lighter_Multi-Voltage.sch, sheet 4]

Parts:
IC7: AD8217; SO08
LED7: LEDCHIP-LED0805; CHIP-LED0805
R13, R14, R15, R19: 100; R0805
R21: 10k\; R0805
R23, R24: 1k; R0805
R29: 2k; R0805
R32, R33, R34, R35: 10k; R0805
R36: 0.05; R2512
T1, T2, T3, T9: IRLML6346; SOT23
T6: IRF7416; SO08
X7: LED_STRIP_4PIN

Connections:
ATMEGA32U4_MOSI: R23.1; also elsewhere on the board
ATMEGA32U4_SCK: R24.1; also elsewhere on the board
GND: IC7.4 (GND), R32.1, R33.1, R34.1, R35.1, T1.2 (S), T2.2 (S), T3.2 (S), T9.2 (S); also elsewhere on the board
unnamed: R13.2, R35.2, T1.1 (G)
unnamed: R14.2, R34.2, T2.1 (G)
unnamed: R15.2, R33.2, T3.1 (G)
unnamed: R23.2, T2.3 (D), X7.2
unnamed: T1.3 (D), X7.1
unnamed: R24.2, T3.3 (D), X7.3
unnamed: T6.5 (D), T6.6 (D), T6.7 (D), T6.8 (D), X7.4
unnamed: LED7.C, R21.1, T6.4 (G), T9.3 (D)
unnamed: R19.1, R32.2, T9.1 (G)
unnamed: LED7.A, R29.1
unnamed: IC7.8 (IN-), R36.1, T6.1 (S), T6.2 (S), T6.3 (S)
PWM_BLUE: R15.1; also elsewhere on the board
PWM_GREEN: R14.1; also elsewhere on the board
PWM_RED: R13.1; also elsewhere on the board
STRIP_CURRENT: IC7.5 (OUT); also elsewhere on the board
STRIP_SUPPLY_EN: R19.2; also elsewhere on the board
VCC_IN: IC7.1 (IN+), R21.2, R29.2, R36.2; also elsewhere on the board

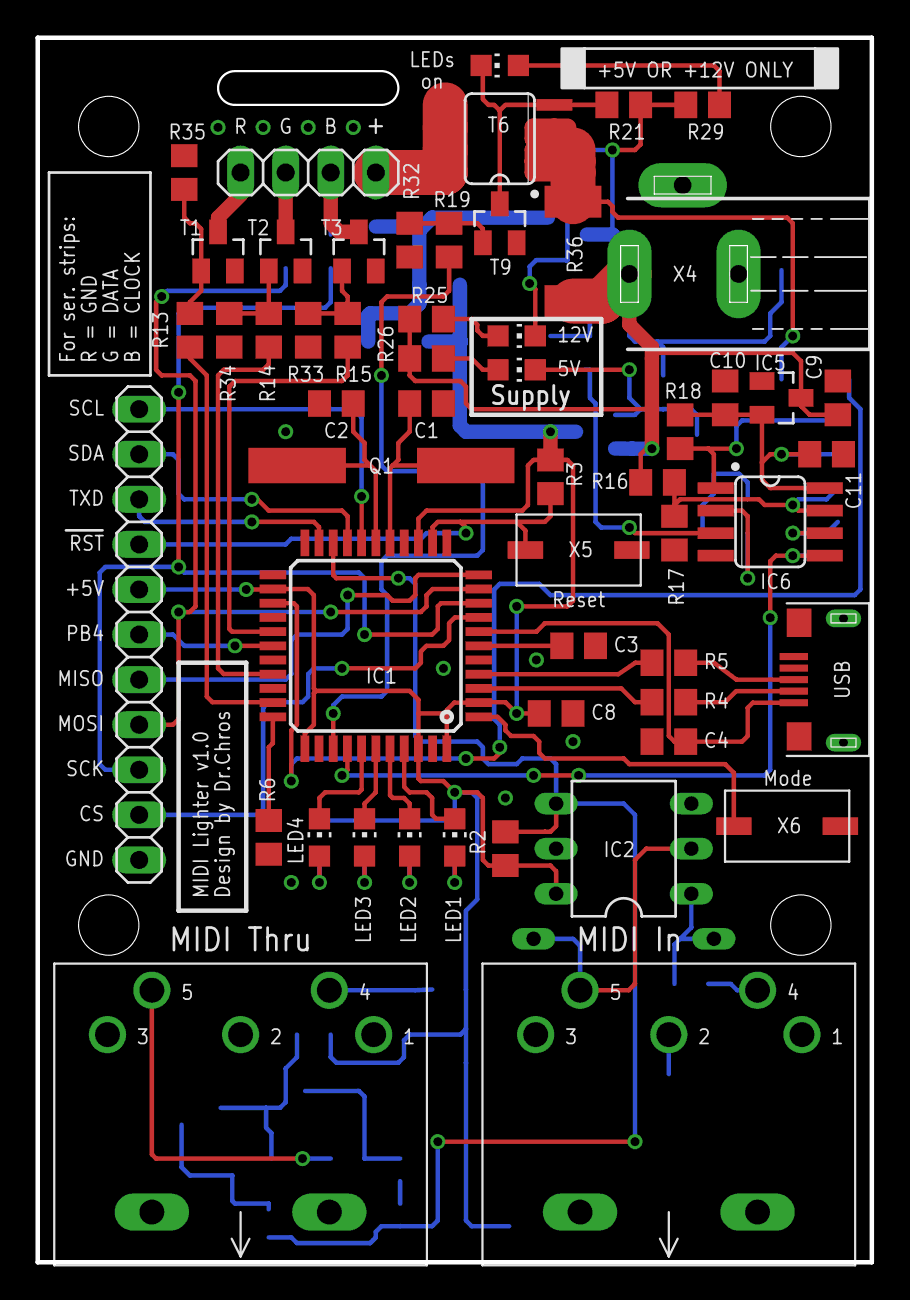
[picture p40: board MIDI_Lighter_Multi-Voltage.brd from above]

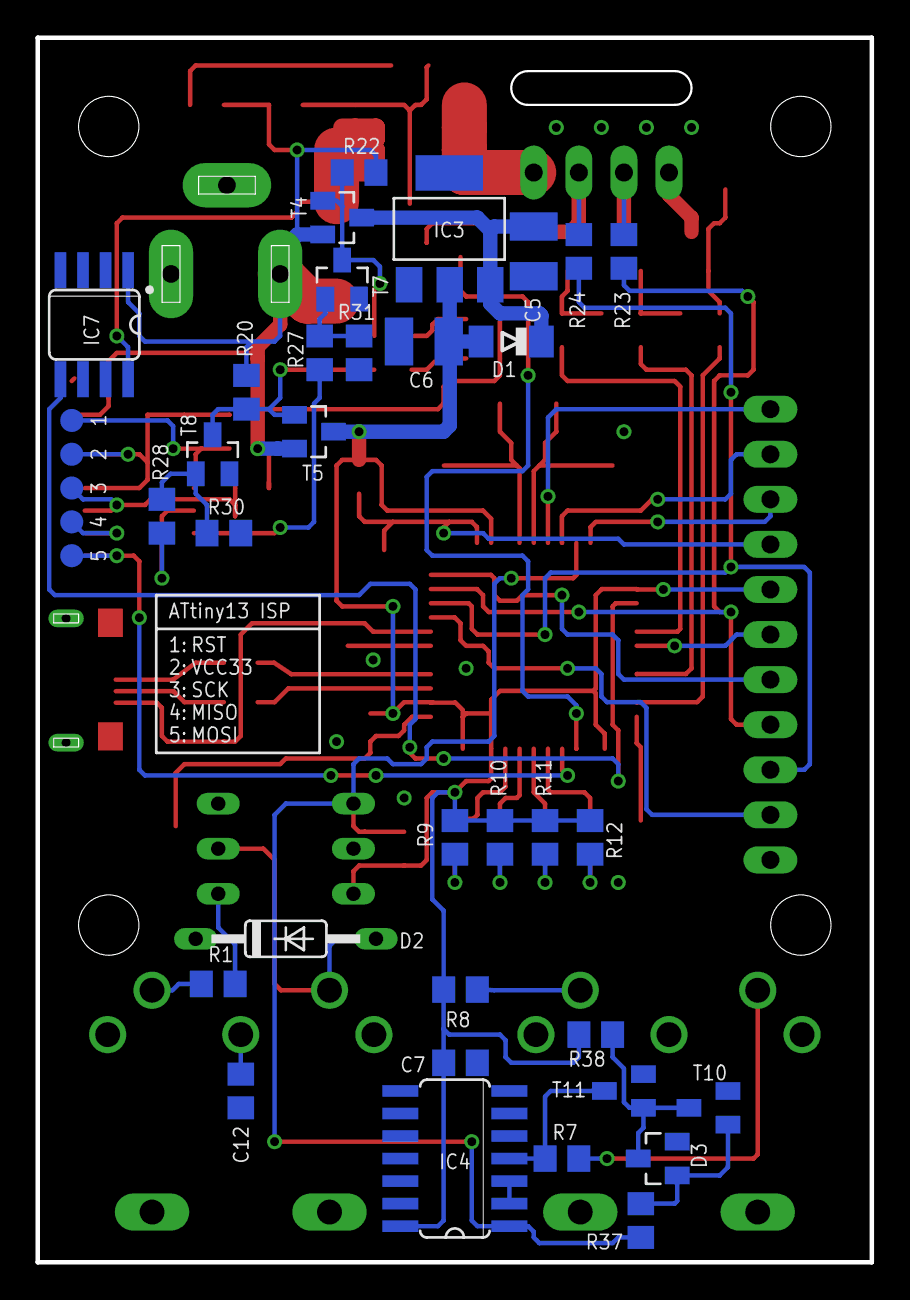
[picture p41: board MIDI_Lighter_Multi-Voltage.brd from below]

Board: 2 copper layers, 47.0 x 69.0 mm, 92 parts (38 on the bottom side), 71 nets.
