MrChros/MIDI_Lighter/Firmware/PCB/MIDI_Lighter/src/Timer_and_Button.h

/*
 * Timer.h
 *
 * Created: 02/06/2018 18:42:55
 *  Author: Chris
 */ 


#ifndef TIMER_H_
#define TIMER_H_

void	Timer_And_Button_Init(void);

uint8_t Timer_General_OV_Occurred(void);
void	Timer_General_Restart(void);
uint8_t	Timer_General_On_LED_Blick(void);

void	Timer_Button_Start(void);
void	Timer_Button_Stop(void);

uint8_t Button_Short_Pressed(void);
uint8_t	Button_Short_State(void);
uint8_t Button_Long_Pressed(void);

void	Timer_No_Data_Light_Reset(void);
uint8_t	Timer_No_Data_Light_On(void);

void	Timer_Set_Timer1_Top(uint16_t top);


#endif /* TIMER_H_ */
