MrChros/MIDI_Lighter/Firmware/PCB/MIDI_Lighter/src/Commands.h

/*
 * Commands.h
 *
 * Created: 24/06/2018 13:15:35
 *  Author: Chris
 */ 


#ifndef COMMANDS_H_
#define COMMANDS_H_

void Commands_Init(void);
void Commands_Process(void);



#endif /* COMMANDS_H_ */
