MrChros/MIDI_Lighter/Firmware/PCB/MIDI_Lighter/src/Help.h

/*
 * Help.h
 *
 * Created: 27.12.2015 15:22:12
 *  Author: Chris
 */ 


#ifndef HELP_H_
#define HELP_H_

int Char_To_Number(char input);
int CharArray_To_Number(volatile char input[], int length);

#endif // HELP_H_
