MrChros/MIDI_Lighter/Firmware/PCB/MIDI_Lighter/src/MIDI.h

/*
 * MIDI.h
 *
 * Created: 16/09/2018 09:14:30
 *  Author: Chris
 */ 


#ifndef MIDI_H_
#define MIDI_H_

void MIDI_Init(void);
void MIDI_Process(void);
void MIDI_Toggle_Mode(void);



#endif /* MIDI_H_ */
