MrChros/MIDI_Lighter/Firmware/PCB/MIDI_Lighter/src/Watchdog.h

/*
 * Watchdog.h
 *
 * Created: 16/09/2018 20:34:58
 *  Author: Chris
 */ 


#ifndef WATCHDOG_H_
#define WATCHDOG_H_

void Watchdog_Disable(void);
void Watchdog_Perform_Reset(void);



#endif /* WATCHDOG_H_ */
