MrChros/MIDI_Lighter/(commit log)

2018-09-30 Initial commit of whole MIDI Lighter project
    [BOM_LCSC_12V.xlsx, BOM_LCSC_MV.xlsx, BOM_LCSC_Template.xlsx, BOM_Reichelt_12V.csv, BOM_Reichelt_MV.csv, Configuration.h, Configuration_MIDI.h, Configuration_No_Data_Light.h]
2018-09-30 MIDI Lighter GUI: - Reorganized object structure - Device List now hold the USB Connection - Former Connection-Object removed
2018-09-30 MIDI Lighter GUI: - Name in Device List is updated with name on device itself
2018-09-30 PCB Firmware: - Added initial functions for ADC
2018-10-01 MIDI Lighter GUI: - Restructuring Debug Functions
    Firmware:
    - Added command to read ADC value
    - Seems to work, but AD8217 is not functioning correctly :(
    [ADC.c, Commands.c, Debug.cpp, Debug.h, Debug_Background_EEPROM.cpp, Device.cpp, Device.h]
2018-10-05 Firmware: - ADC is working now - Reason for not working current measurement was missing protection at differential input of AD8217 - Two opposite oriented diodes parallel to the shunt resistor solve 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
    Software:
    - Implemented debug interface - not very useful yet, but fits the debugging
    Documents:
    - Added Spep Calculation Sheet for ADC Values
    [ADC.c, Debug.cpp]
2018-10-07 Firmware: - Added configuration parameter for "No Data Light" - It is now possible to select, when the "No Data Light" shall be switched off
    - Updated GUI accordingly with ComboBox to select the new Parameter
    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
    [Configuration.h, Configuration_No_Data_Light.h, Configuration_Permanent_Light.h]
2018-10-07 Firmware: - Added basic SPI Library - Added Debug Outputs to MIDI Parsing function
    Documentation:
    - Added Measurements of Skip Note Off function
    [MIDI_Lighter_12V_Only_Top_Debug.scad, MIDI_Lighter_12V_Only_Top_Debug.stl]
2018-10-07 Software: - Implemented handling of multiple connected devices - Seems to work and number should be unlimited (tested with only two devices)
2018-10-08 Firmware: - Just removed debug pin declarations in MIDI.c - Added comment to MIDI.c
    - Added information about random MIDI data sent by Behringer XR18
    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
2018-10-22 Firmware: - Lots of testing with ADC using smart Algorithms - nothing really worked so far - Should be stable now
    GUI:
    - Added a bit fanciness
    - Added release build version (Debug buttons are disabled)
    - Added debug auto test to change PWM frequency and ADC frequency
    [Configuration_No_Data_Light.h, Configuration_Permanent_Light.h, Current_Measurement.xlsx, PWM.xlsx]
2018-10-26 Software: - Added first attempts for auto DPI scaling of the Software (not working yet)
    [Configuration_MIDI.cpp, Device.cpp, Device_List.cpp, MIDI_Lighter_GUI.cpp]
2022-03-05 Commiting modified changes from a long time ago. I do not recall what changes were made, but the diff shows quite some entries. One of the last things definitely concerned the investigation of the XR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
    [BOM_Reichelt_12V.csv, BOM_Reichelt_MV.csv, Configuration.h, Configuration_MIDI.h, Configuration_No_Data_Light.h, Configuration_Permanent_Light.h, Configuration_RGB_Order.h, MIDI_Lighter_12V_Only.brd]
